calvinwalterheintzelman/Senior-Design-Project-Website/Team/progress/img/header.jpg

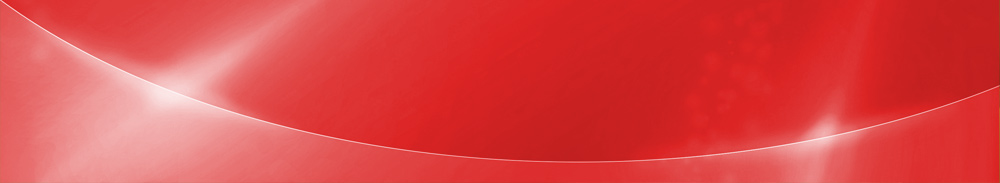
Team/progress/img/header.jpg
