calvinwalterheintzelman/Senior-Design-Project-Website/img/abiala/codec (2).JPG

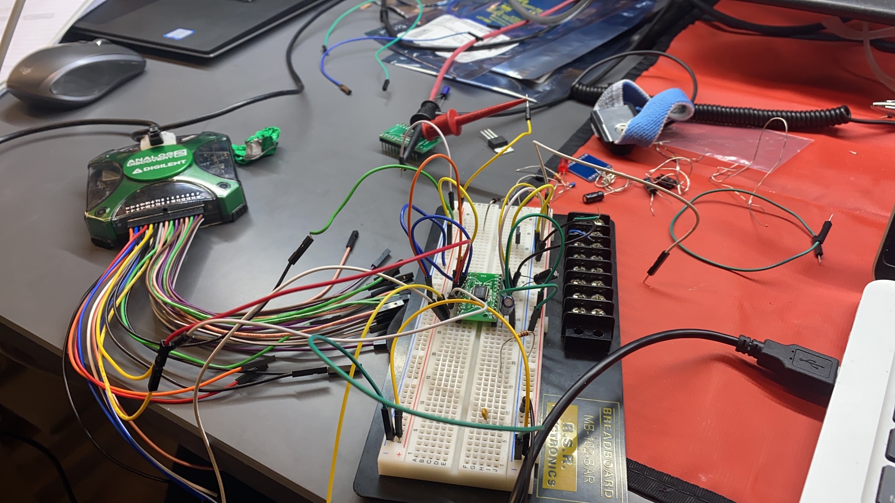
img/abiala/codec (2).JPG
