calvinwalterheintzelman/Senior-Design-Project-Website/Homeworks/Archive/Documents/team08-homework01 (PSSC's to be edited).docx

Final Project Proposal

Year: 2020

Semester: Spring

Team: 8

Project Name: AudioBeamer

Creation Date: November 3, 2019

Last Modified: January 5th, 2019

Team Members (#1 is Team Leader):

Member 1: Carson Tabachka Email: ctabachk@purdue.edu

Member 2: Calvin Walter Heintzelman Email: cheintze@purdue.edu

Member 3: Aditya Biala Email: abiala@purdue.edu

Member 4: Aditya Thagarthi Arun Email: athagart@purdue.edu

1.0 Description of Problem:

Playing an electric guitar with an amplifier can be such a hassle when there are electric cords everywhere. Needing to constantly untangle and untie cords when all you want to do is jam is such a bummer. People who play guitar should be able to pick up and play their instrument seamlessly and effortlessly. Wireless technology is everywhere nowadays, so why is it not mainstream for guitar players to have wireless audio transmission between their guitars and amplifiers? There are about 16 million guitar players just in the United States [1] and all of them could potentially run into this issue when using an amplifier.

In addition to the proposed guitar application, we plan to make our system universal. It should be compatible with any electronic music instrument that outputs sound using a 3.5mm or 6.3mm audio port. (DJ Controllers, Digital synthesizer etc.)

2.0 Roles & Responsibilities:

1. Team Leader – Carson Tabachka
  - Carson has great interpersonal communication skills. He coordinated his environmental engineering team to best delegate tasks and ensure timely completion. He has interest in software design especially with respect to networking and security.
2. Systems Engineer – Aditya Thagarthi Arun
  - Aditya T A has interest in software development. He will also understand the PCB design in full in order to serve the role as a systems engineer in this team. He has personal interest in audio and has a prior experience with working on audio related projects. He will be responsible with tying the hardware and software components of this project.
3. Hardware Engineer – Aditya Biala
  - Aditya B. has experience with Audio Hardware Development during projects with his internship with the audio team at Amazon. Additionally, he has completed numerous audio projects involving PCB design and embedded software both personally and as part of coursework. He has a lot of interest in audio hardware, and therefore he will be responsible for reliable, robust hardware design of this project.
4. Software Engineer – Calvin Walter Heintzelman
  - Calvin has a personal interest in software engineering and has taken specialized classes regarding the topic, including a class in software for embedded systems. He has done personal projects and has developed websites, apps, and neural networks. He will therefore be primarily responsible for the proper functionality and quality of software/code.

2.1 Homework Assignment Responsibilities:

Design Component Homework | | Professional Component Homework
3-Software Overview | A.T.A | 9-Legal Analysis | C.W.H.
5-Electrical Overview | A.B. | 10-Reliability and Safety Analysis | A.B.
7-Mechanical Overview | C.T. | 11-Ethical/Environmental Analysis | C.T.
8-Software Formalization | C.W.H. | 12-User Manual | A.T.A.

Carson Tabachka - C.T. Aditya Thagarthi Arun - A.T.A.

Aditya Biala - A.B. Calvin Walter Heintzelman - C.W.H.

3.0 Estimated Budget:

Item | Estimated Price
Electrical
Microcontrollers | $30
3.5 mm to 6.35 mm converter https://www.amazon.com/UGREEN-6-35mm-Female-Stereo-Adapter/dp/B01D82XXGO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 | $8
NRF24L01 Transceiver | $10
Batteries | $20
PCB | $70
Miscellaneous Electrical components (resistors, wires, LEDs, etc) | $10
Non-Electrical
3D printing material | $25
Shipping Costs | $50
Total | $223

4.0 Project Specific Success Criteria:

1. The ability to interface with an external Audio Codec using I2S that delivers digital data sampled at a 16-bit resolution from an electric guitar and outputs analog audio.
2. The ability to use Bluetooth data received from an Android cell phone to control audio equalization on the Receiver PCB using UART.
3. The ability to apply audio effects & equalization such as bass, middle, treble, distortion, and reverb on digitally sampled audio using Digital Signal Processing.
4. The ability to use a developed Android app to pass user-customizable audio equalization data to the receiver MCU using inbuilt cell phone Bluetooth.
5. The ability to power the system using an external battery while being able to measure remaining battery levels using a coulomb meter and displaying it using an LED based UI.

5.0 Sources Cited:

[1] “Guitar Players in The United States.” Answers.Google.com. http://answers.google.com/answers/threadview/id/720968.html (accessed Nov. 7, 2019).
[2] “900 MHz vs 433 MHz for Urban Environments.” Electronics.StackExchange.com. https://electronics.stackexchange.com/questions/115429/900-mhz-vs-433-mhz-for-urban-environments (accessed Nov. 7, 2019).
[3] “ARISTA 16-097 3.5mm (Mini) to 6.3mm (1/4") Headphone Adapter.” Amazon.com. https://www.amazon.com/ARISTA-16-097-3-5mm-Headphone-Adapter/dp/B00009UVPN (accessed Nov. 7, 2019).
[4] R. Davis. “Cordless Guitar Transmitter.” Patents.Google.com. https://patents.google.com/patent/US5025704?oq=wireless+audio+transmitter+and+receiver+guitar (accessed Nov. 7, 2019).
[5] “Xvive U2 Guitar Wireless System with Rechargeable 2.4GHz Digital Guitar Transmitter and Receiver for Electric Guitar, Bass, Violin.” Amazon.com. https://www.amazon.com/Xvive-Wireless-Rechargeable-Transmitter-Receiver/dp/B01N4DSQBR?ref_=fsclp_pl_dp_1&th=1 (accessed Nov. 7, 2019).
[6] “Donner New Version Rechargeable Wireless System DWS-3 Digital Guitar Bass Audio Transmitter and Receiver.” Amazon.com. https://www.amazon.com/Donner-Rechargeable-Wireless-Transmitter-Receiver/dp/B07DHLCRKD?ref_=fsclp_pl_dp_6 (accessed Nov. 7, 2019).
[7] “Getaria 2.4GHZ Wireless Guitar System Built-in Rechargeable Lithium Battery Digital Transmitter Receiver for Electric Guitar Bass (Black).” Amazon.com. https://www.amazon.com/Getaria-Wireless-Rechargeable-Transmitter-Receiver/dp/B07L5B64RG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 (accessed Nov. 7, 2019).
[8] 胡宇鹏. “Wireless Transmitter Suitable for Electric Guitar.” Patents.Google.com. https://patents.google.com/patent/CN205140505U/en?oq=guitar+transmitter (accessed Nov. 7, 2019).
[9] M. Kleinsorge and C. Budnik. “High-Frequency Transmitter, Wireless Microphone and Guitar Transmitter or Pocket Transmitter.” Patents.Google.com. https://patents.google.com/patent/US20150303886?oq=guitar+transmitter (accessed Nov. 7, 2019).
[10] “FM-Based Wireless Electric Guitar!” Instructables.com. https://www.instructables.com/id/FM-based-Wireless-Electric-Guitar/ (accessed Nov. 7, 2019).
[11] “Beetle Mk III: Connect your Guitar to the Airwaves.” TalkingElectronics.com. http://www.talkingelectronics.com/projects/BeetleMklll/BeetleMkIII.html (accessed Nov. 7, 2019).
[12] M. Caldeira. “DIY Wireless Guitar System Using NRF24L01.” YouTube.com. https://www.youtube.com/watch?v=66lN1GD_TN4 (accessed Nov. 7, 2019).

Appendix 1: Concept Sketch

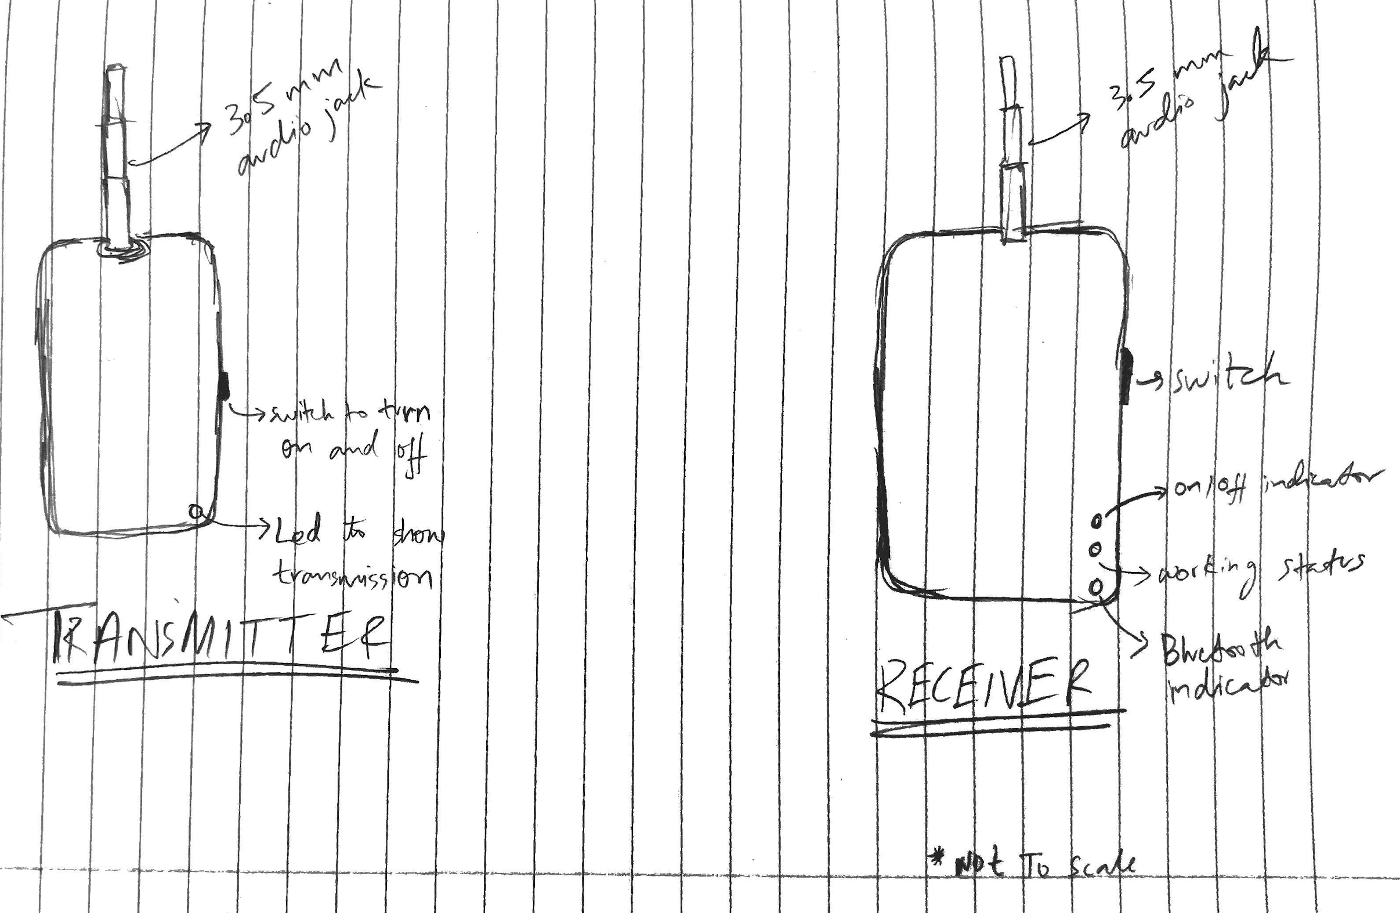
[picture p50: figure]
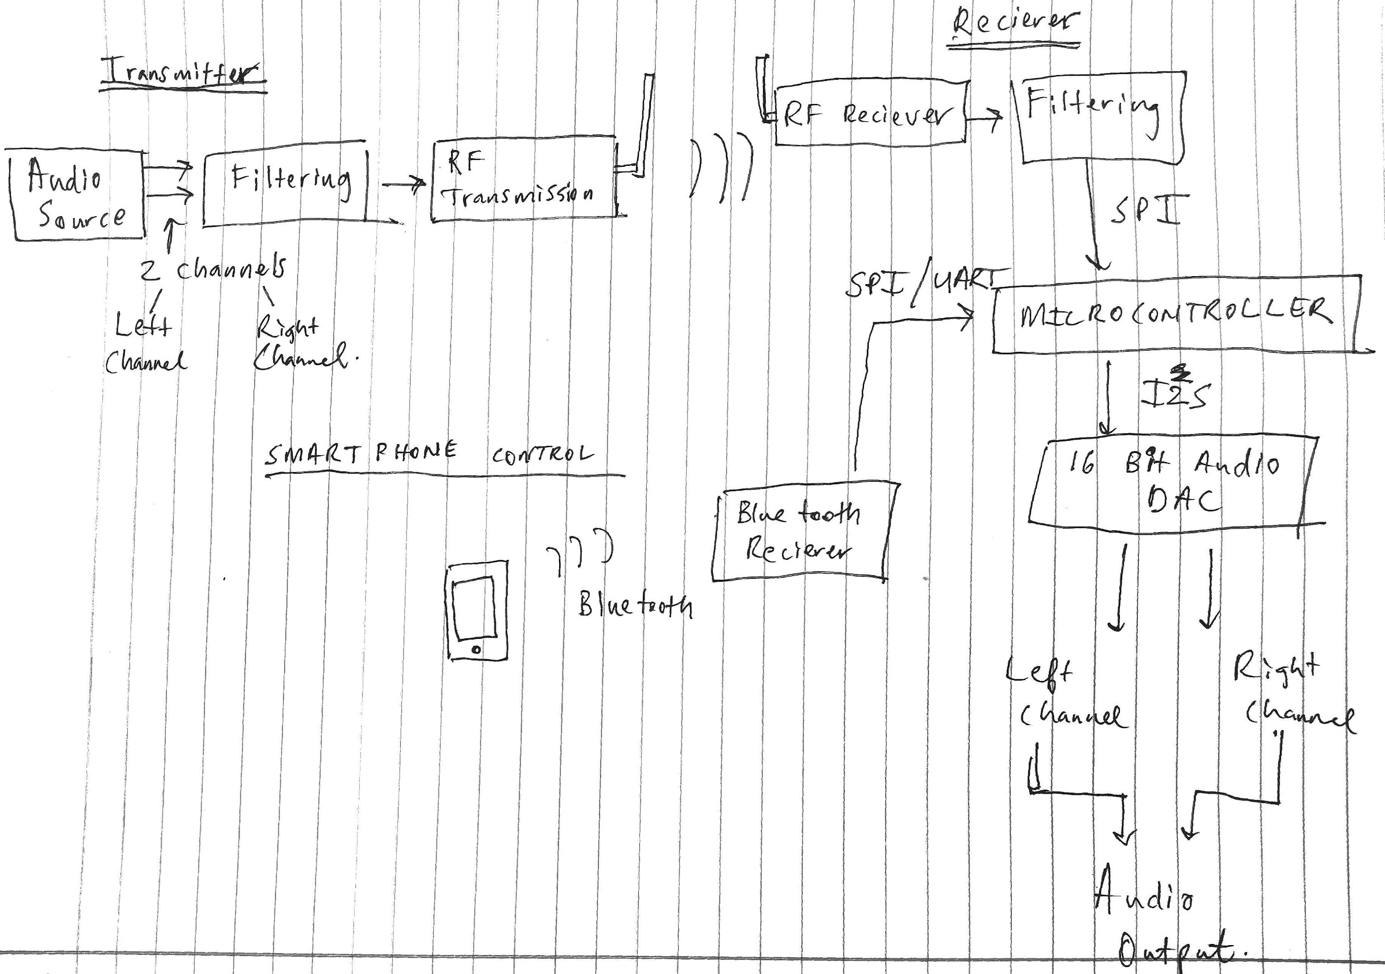
[picture p51: figure]
