calvinwalterheintzelman/Senior-Design-Project-Website/Homeworks/Archive/Documents/Midterm Design Reveiw/GANT chart.xlsx

Task | Week 8 | Week 9 | Week 10 | Week 11 | Week 12 | Week 13 | Week 14 | Week 15 | Week 16
Audio Codec Interfacing
Order PCB
DSP Development
Android App UI Improvements
Soldering
Software Debugging
Hardware Debugging
Product testing
Assembly
Quality of Life Improvements
Finalize PCB Designs
PMIC Interfacing
