calvinwalterheintzelman/Senior-Design-Project-Website/img/abiala.jpg

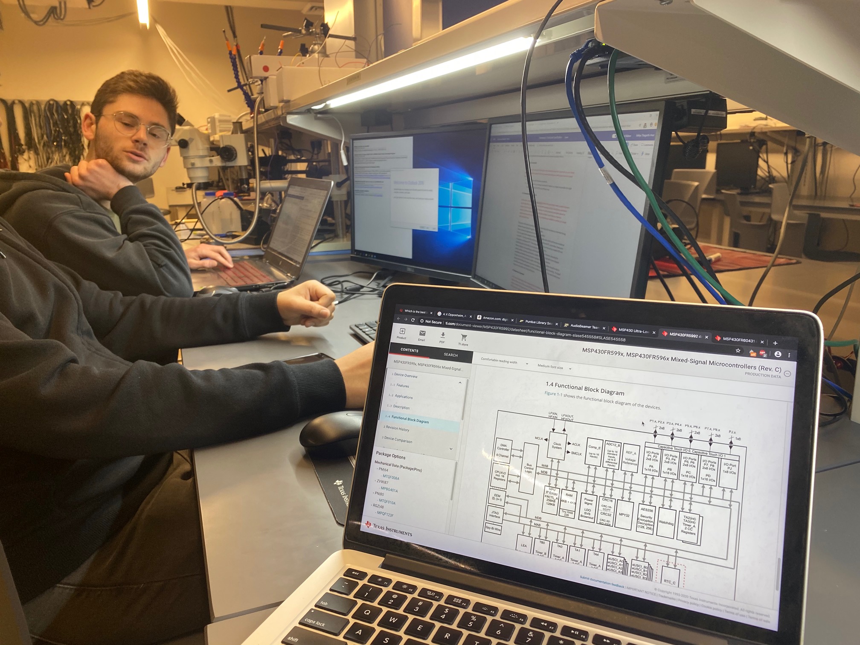
img/abiala.jpg
