calvinwalterheintzelman/Senior-Design-Project-Website/img/abiala/1.jpg

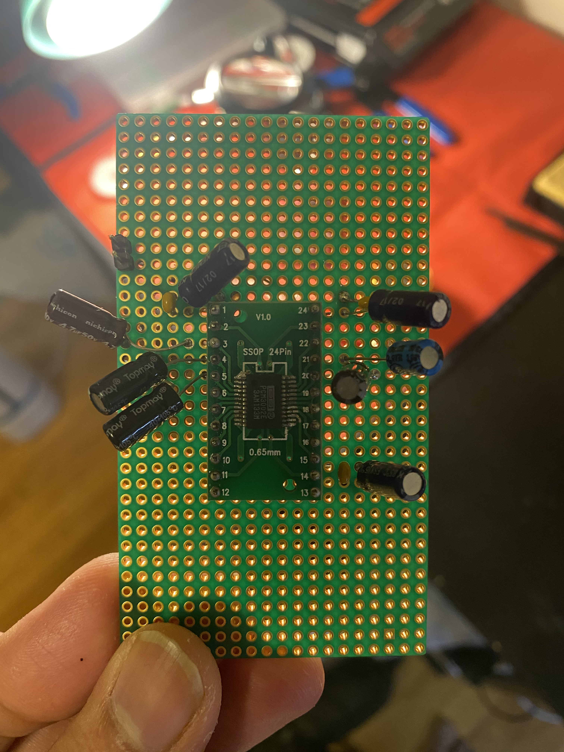
img/abiala/1.jpg
