calvinwalterheintzelman/Senior-Design-Project-Website/img/abiala/2.jpg

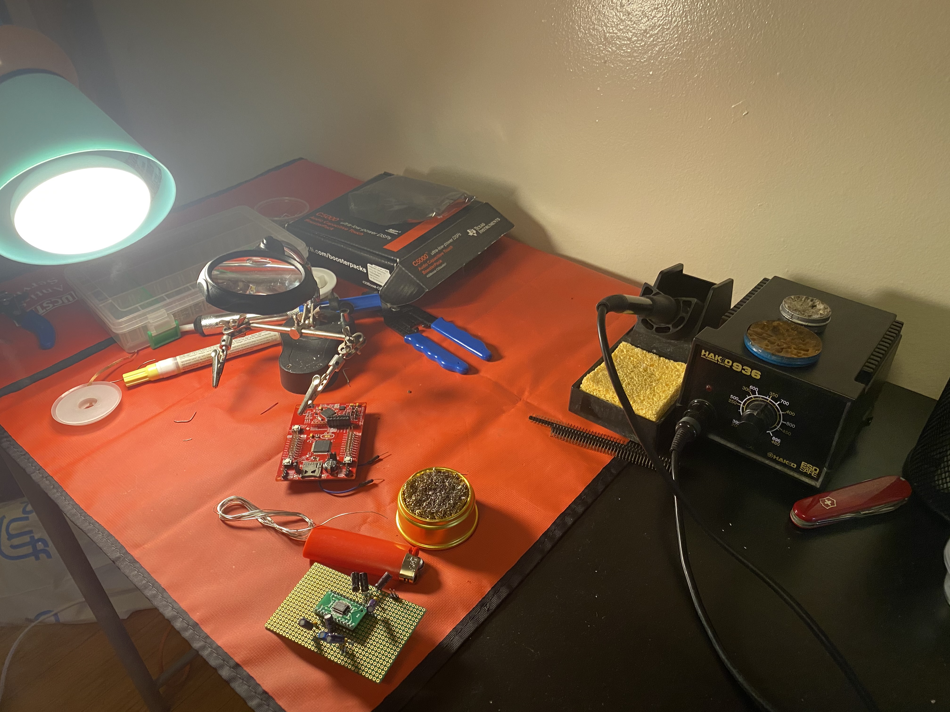
img/abiala/2.jpg
