calvinwalterheintzelman/Senior-Design-Project-Website/img/abiala/circuit.jpg

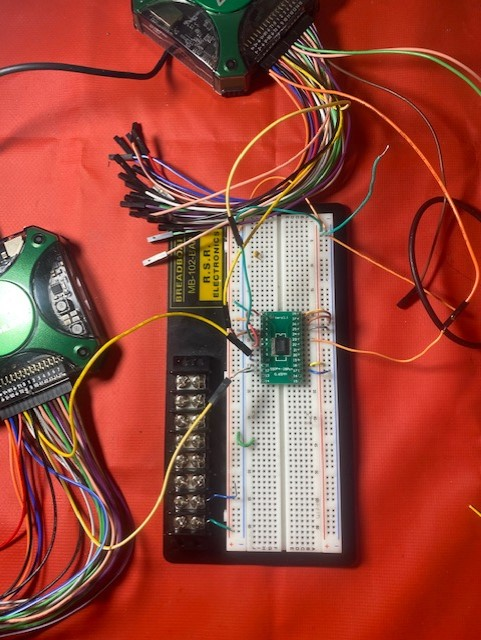
img/abiala/circuit.jpg
