calvinwalterheintzelman/Senior-Design-Project-Website/img/abiala/crystal.jpg

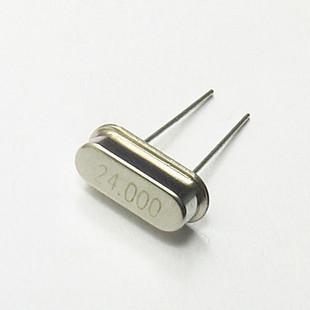
img/abiala/crystal.jpg
