calvinwalterheintzelman/Senior-Design-Project-Website/img/abiala/dsp.png

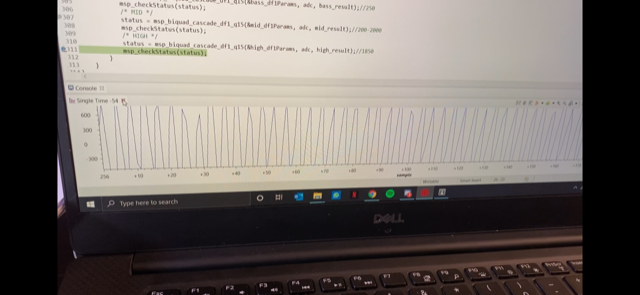
img/abiala/dsp.png
