calvinwalterheintzelman/Senior-Design-Project-Website/img/abiala/footprint.png

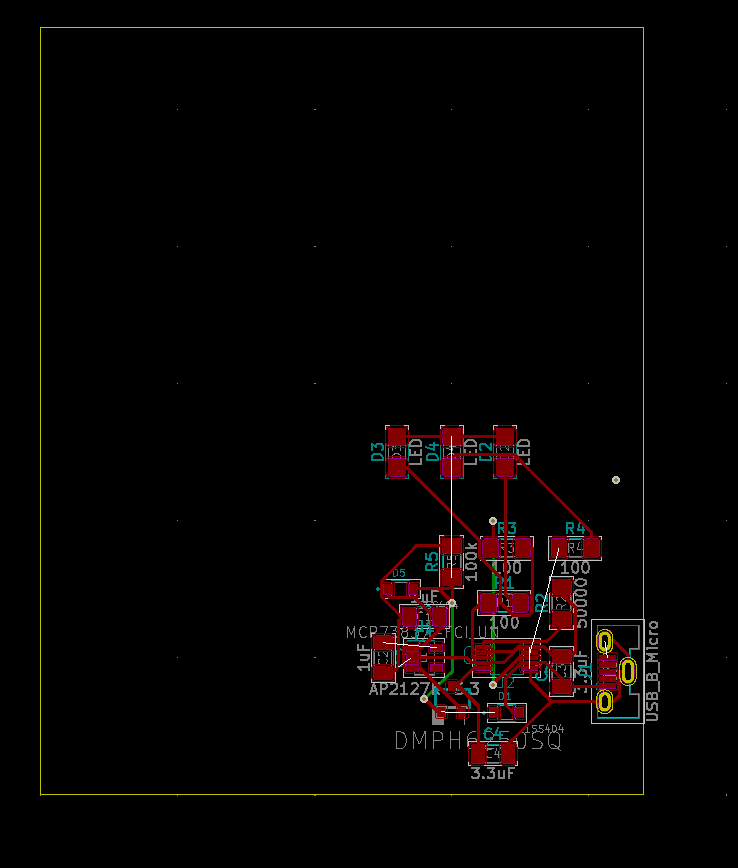
img/abiala/footprint.png
