calvinwalterheintzelman/Senior-Design-Project-Website/img/abiala/msp.png

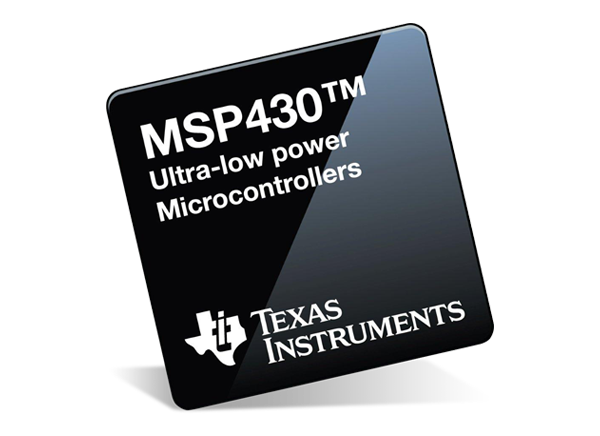
img/abiala/msp.png
