calvinwalterheintzelman/Senior-Design-Project-Website/img/abiala/new_codec.jpg

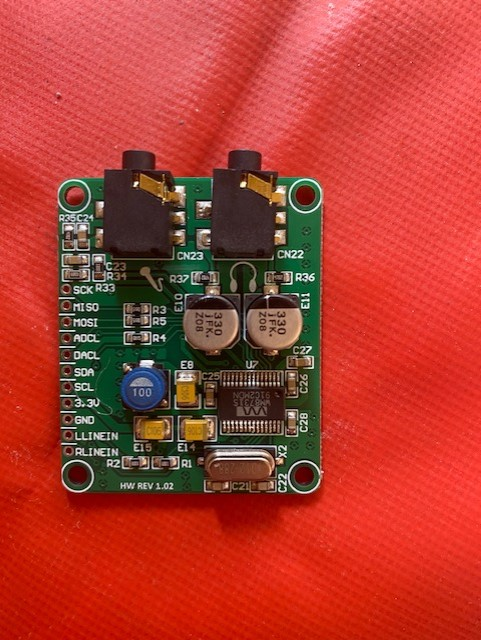
img/abiala/new_codec.jpg
