calvinwalterheintzelman/Senior-Design-Project-Website/img/abiala/pcb1.png

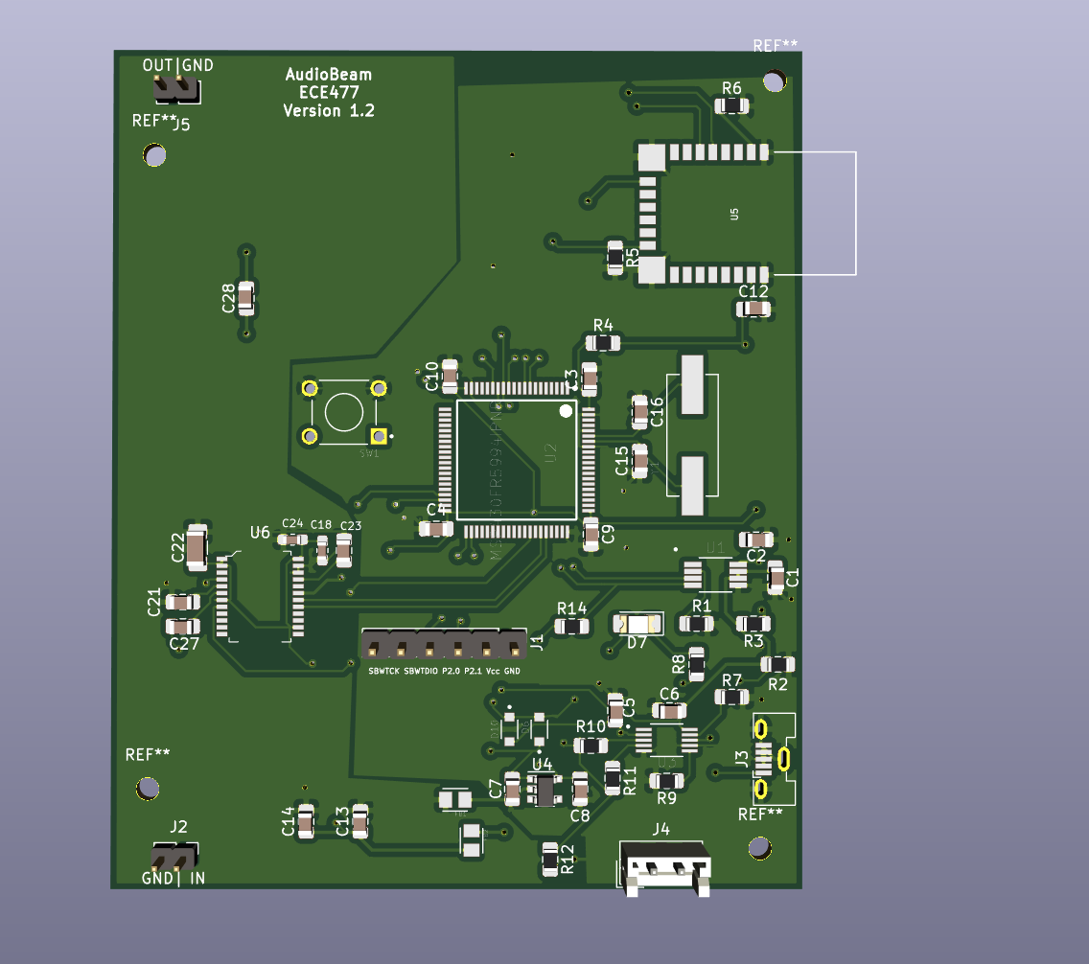
img/abiala/pcb1.png
