calvinwalterheintzelman/Senior-Design-Project-Website/img/abiala/PCB.png

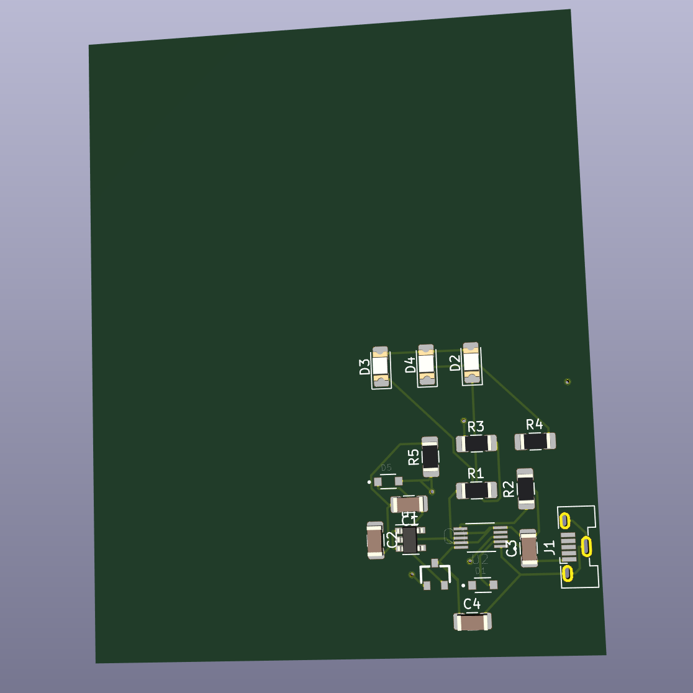
img/abiala/PCB.png
