calvinwalterheintzelman/Senior-Design-Project-Website/img/app1 (2).JPG

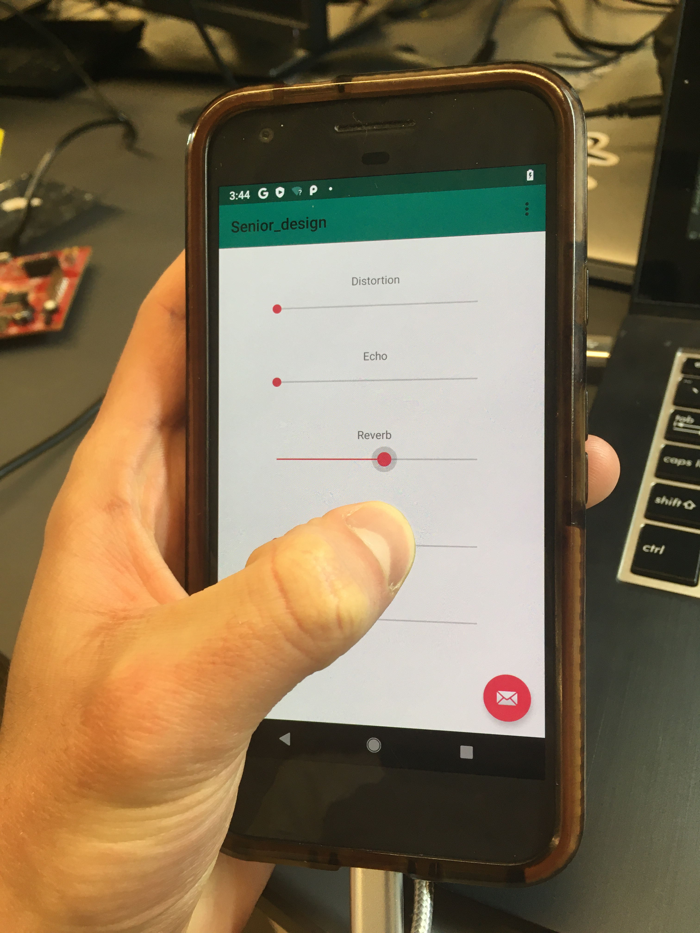
img/app1 (2).JPG
