calvinwalterheintzelman/Senior-Design-Project-Website/img/athagart/athagart2.jpg

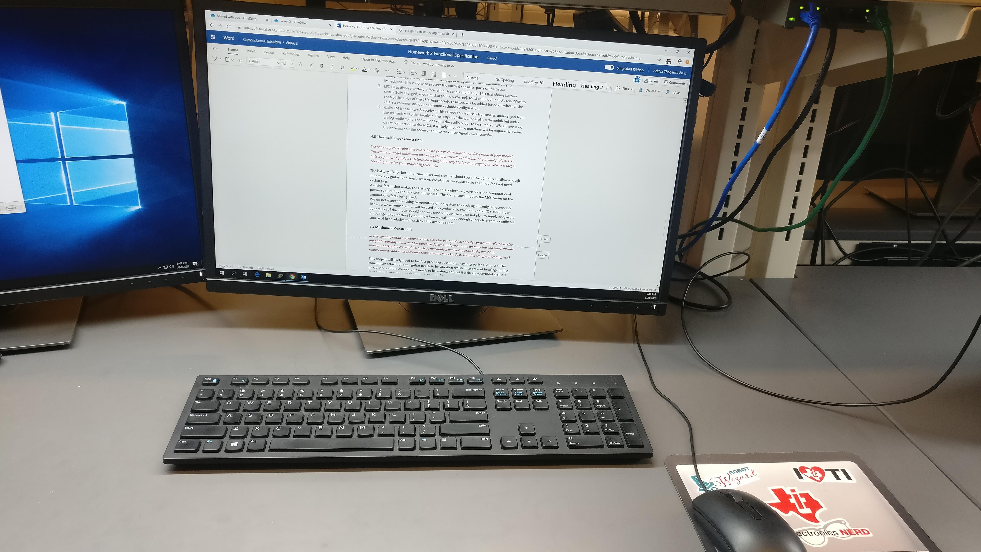
img/athagart/athagart2.jpg
