calvinwalterheintzelman/Senior-Design-Project-Website/img/athagart/athagart3a.png

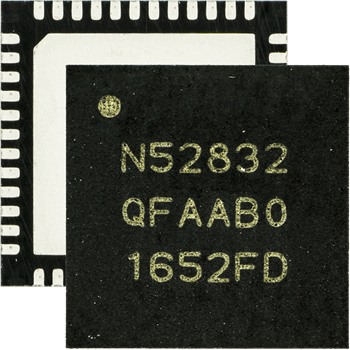
img/athagart/athagart3a.png
