calvinwalterheintzelman/Senior-Design-Project-Website/img/athagart/athagart3b.png

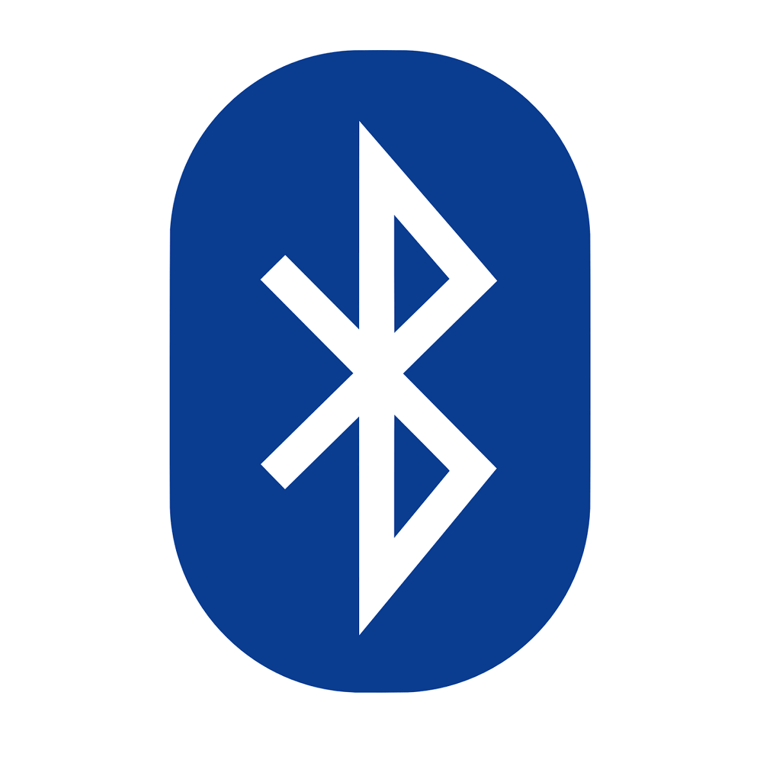
img/athagart/athagart3b.png
