calvinwalterheintzelman/Senior-Design-Project-Website/img/athagart/athagart3c.png

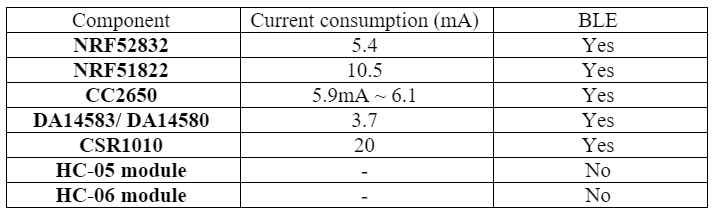
img/athagart/athagart3c.png
