calvinwalterheintzelman/Senior-Design-Project-Website/img/athagart/Capture.JPG

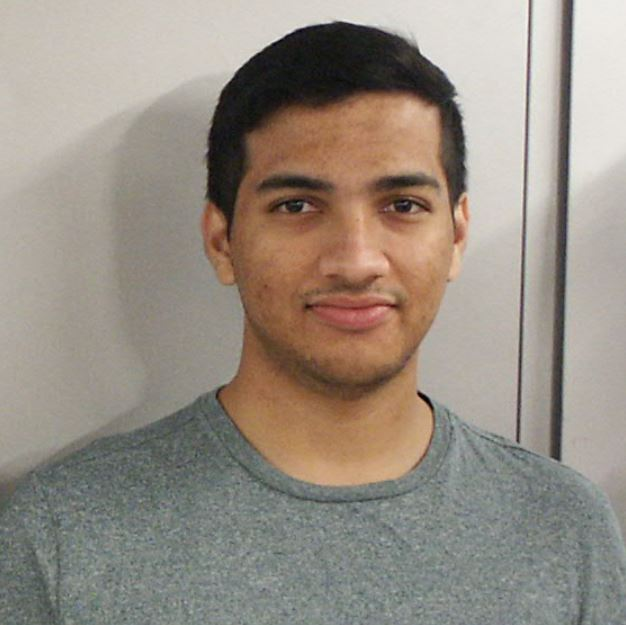
img/athagart/Capture.JPG
