calvinwalterheintzelman/Senior-Design-Project-Website/img/athagart/image.png

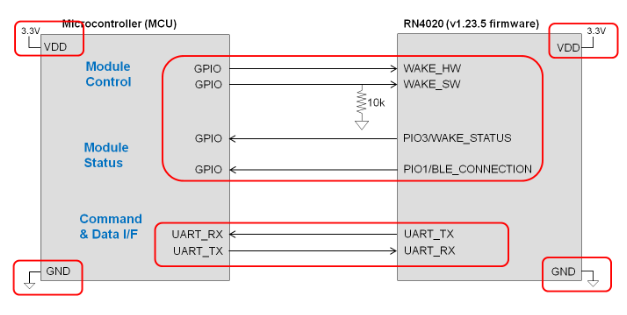
img/athagart/image.png
