calvinwalterheintzelman/Senior-Design-Project-Website/img/athagart/rn4020.jpg

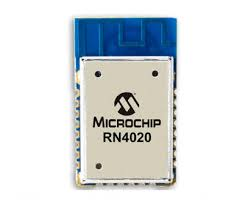
img/athagart/rn4020.jpg
