calvinwalterheintzelman/Senior-Design-Project-Website/img/athagart/week6a.png

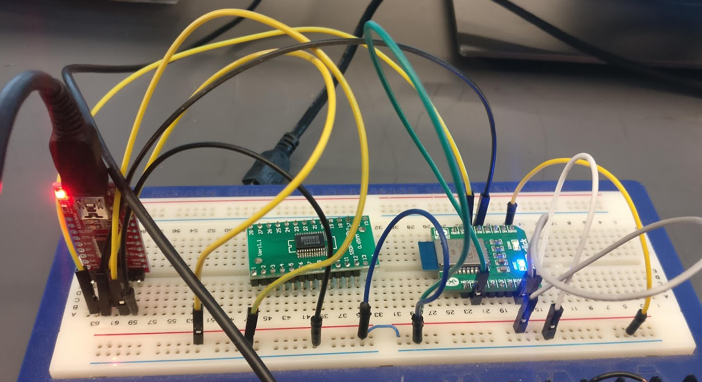
img/athagart/week6a.png
