calvinwalterheintzelman/Senior-Design-Project-Website/img/athagart/week6b.png

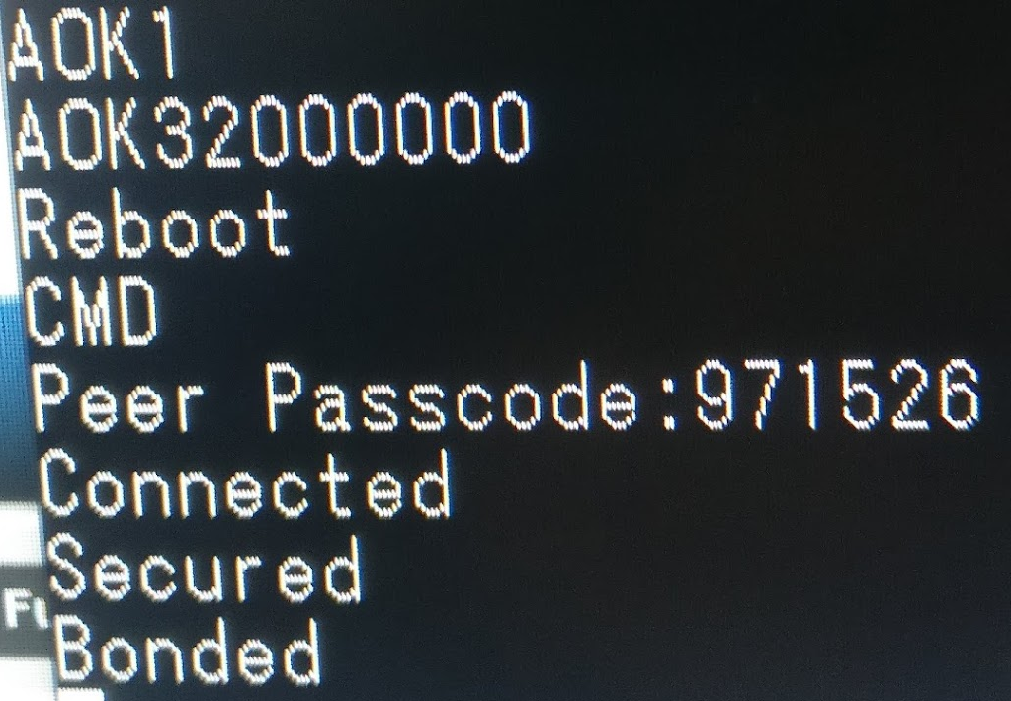
img/athagart/week6b.png
