calvinwalterheintzelman/Senior-Design-Project-Website/img/athagart/week7a.png

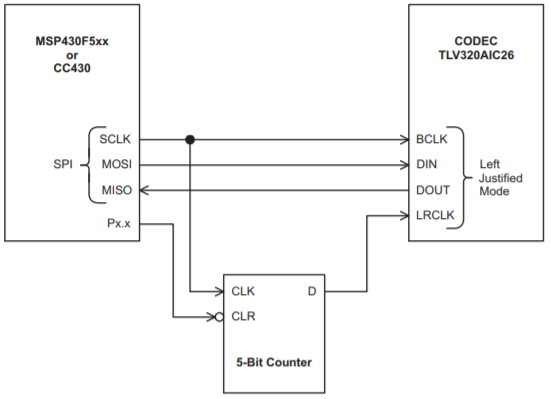
img/athagart/week7a.png
