calvinwalterheintzelman/Senior-Design-Project-Website/img/athagart/week7b.png

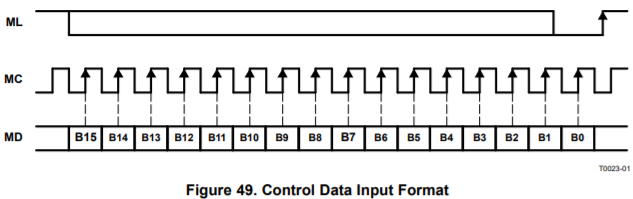
img/athagart/week7b.png
