calvinwalterheintzelman/Senior-Design-Project-Website/img/athagart/week8.png

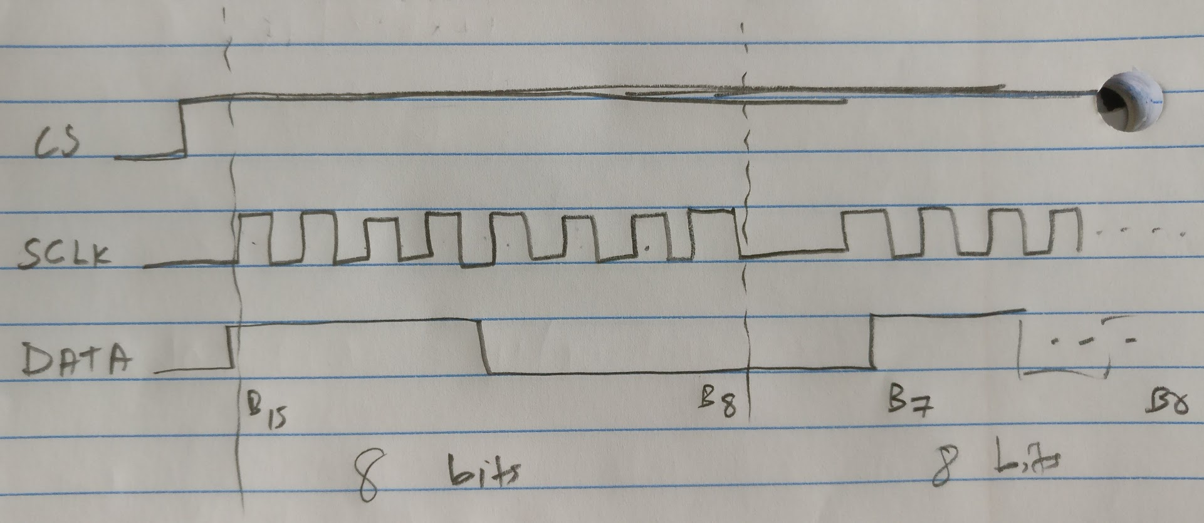
img/athagart/week8.png
