calvinwalterheintzelman/Senior-Design-Project-Website/img/athagart/week12.png

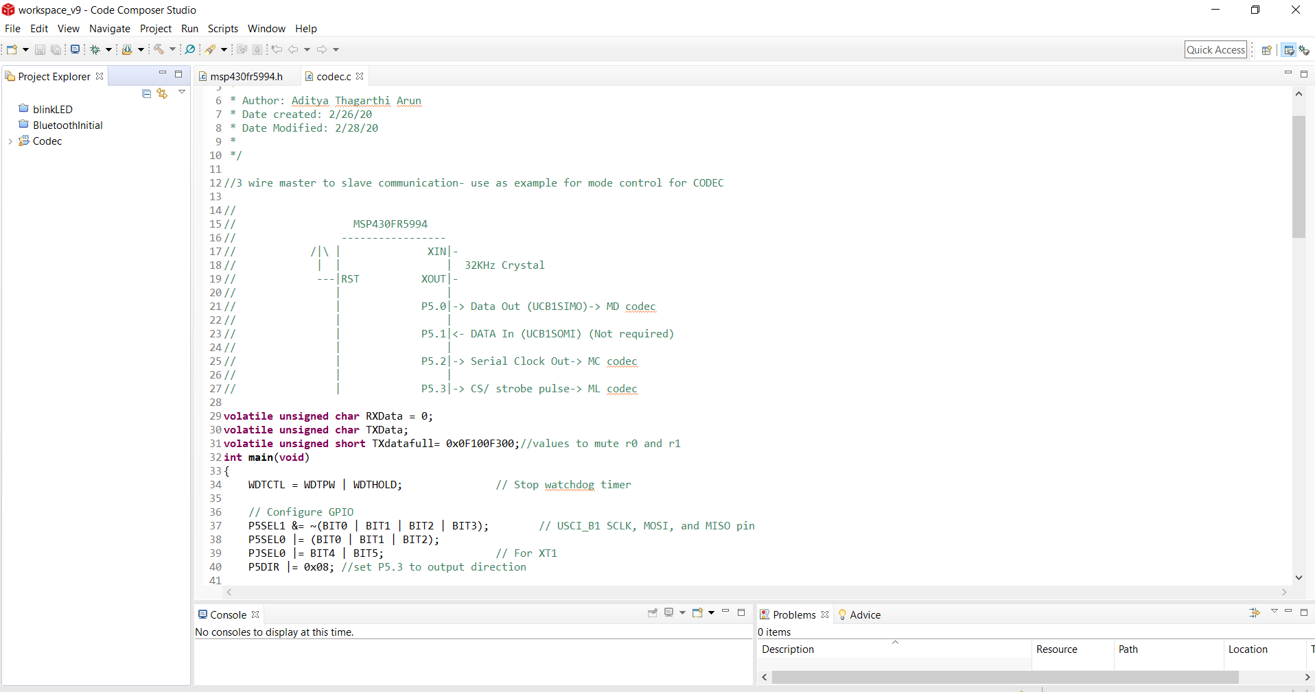
img/athagart/week12.png
