calvinwalterheintzelman/Senior-Design-Project-Website/img/athagart/week13.png

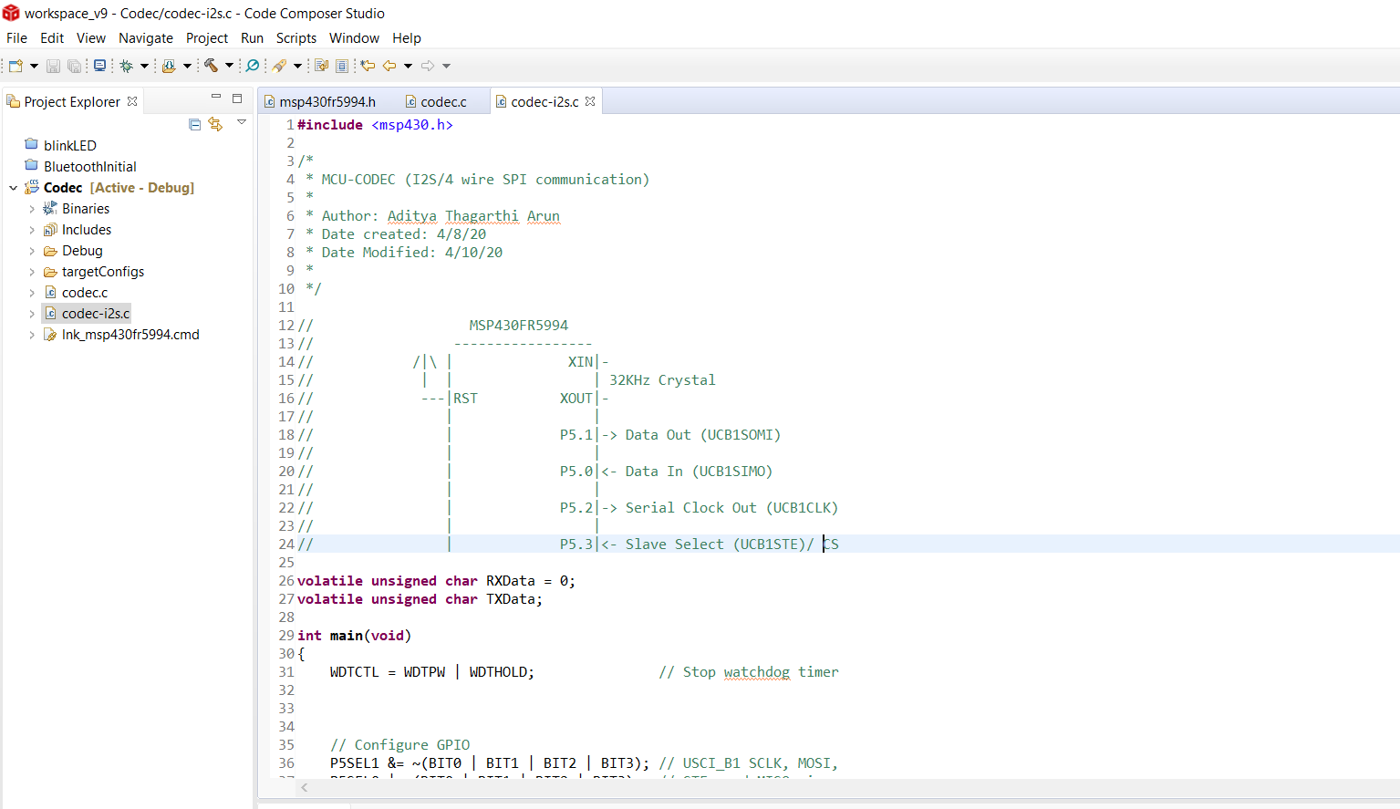
img/athagart/week13.png
