calvinwalterheintzelman/Senior-Design-Project-Website/img/athagart/week14a.jpg

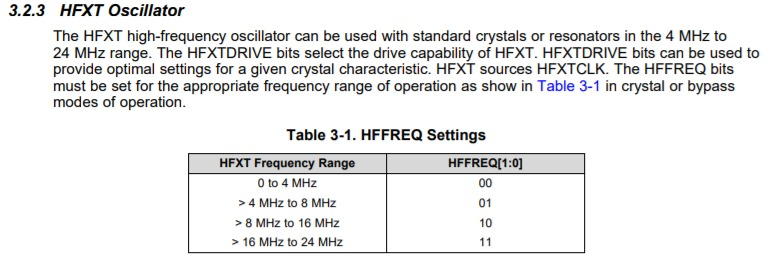
img/athagart/week14a.jpg
