calvinwalterheintzelman/Senior-Design-Project-Website/img/athagart/week15.jpg

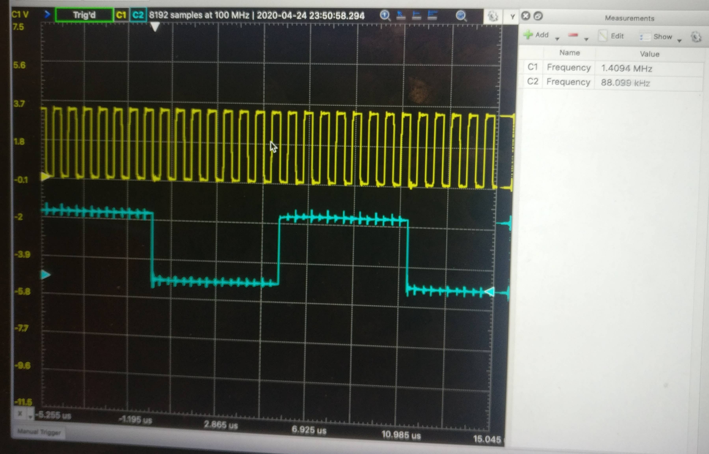
img/athagart/week15.jpg
