calvinwalterheintzelman/Senior-Design-Project-Website/img/circuit2.png

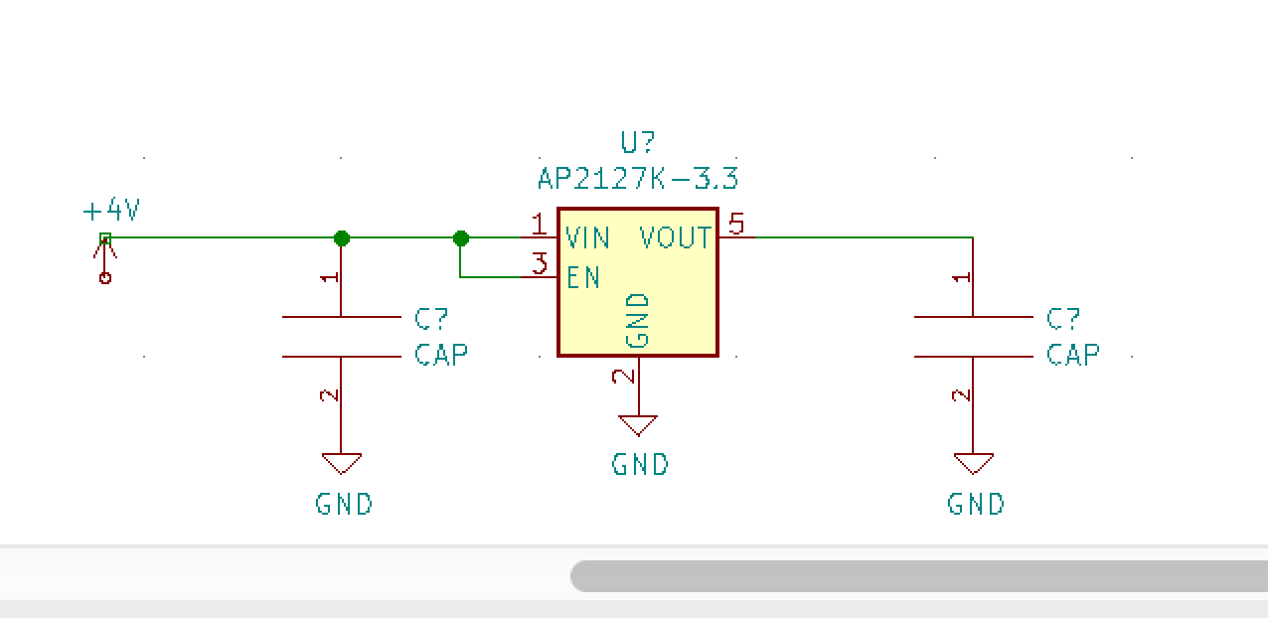
img/circuit2.png
