calvinwalterheintzelman/Senior-Design-Project-Website/img/circuit.png

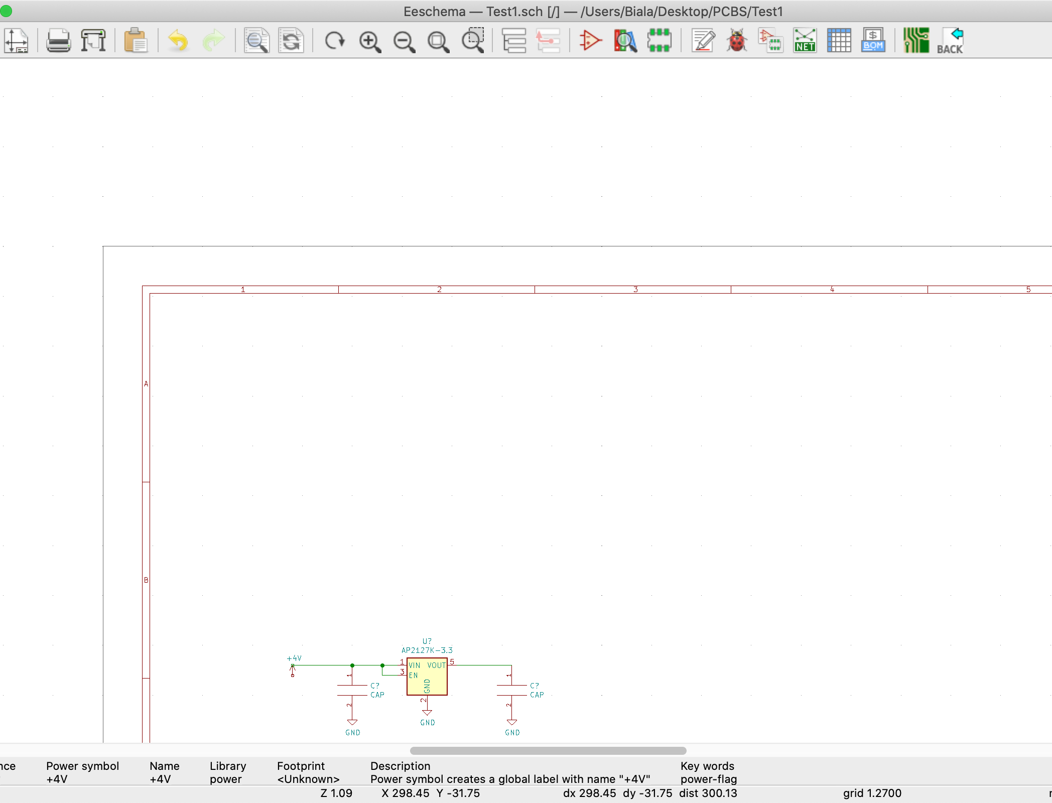
img/circuit.png
