calvinwalterheintzelman/Senior-Design-Project-Website/img/code1.png

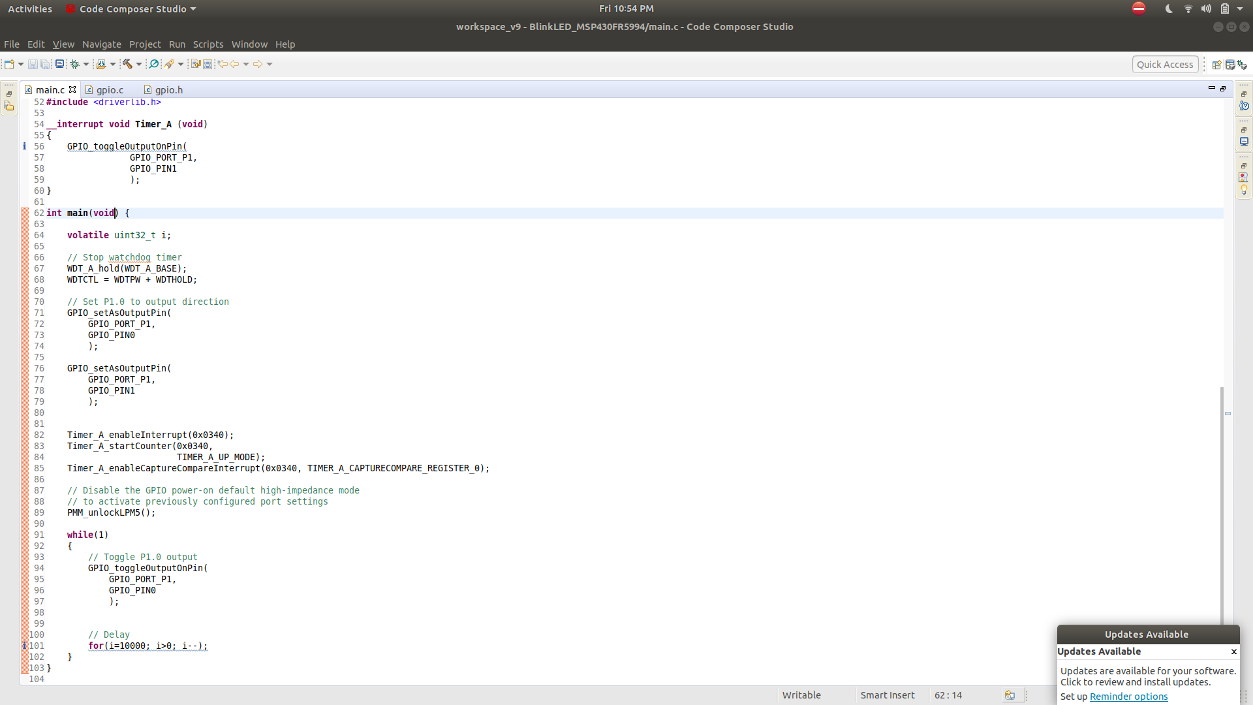
img/code1.png
