calvinwalterheintzelman/Senior-Design-Project-Website/img/code2.png

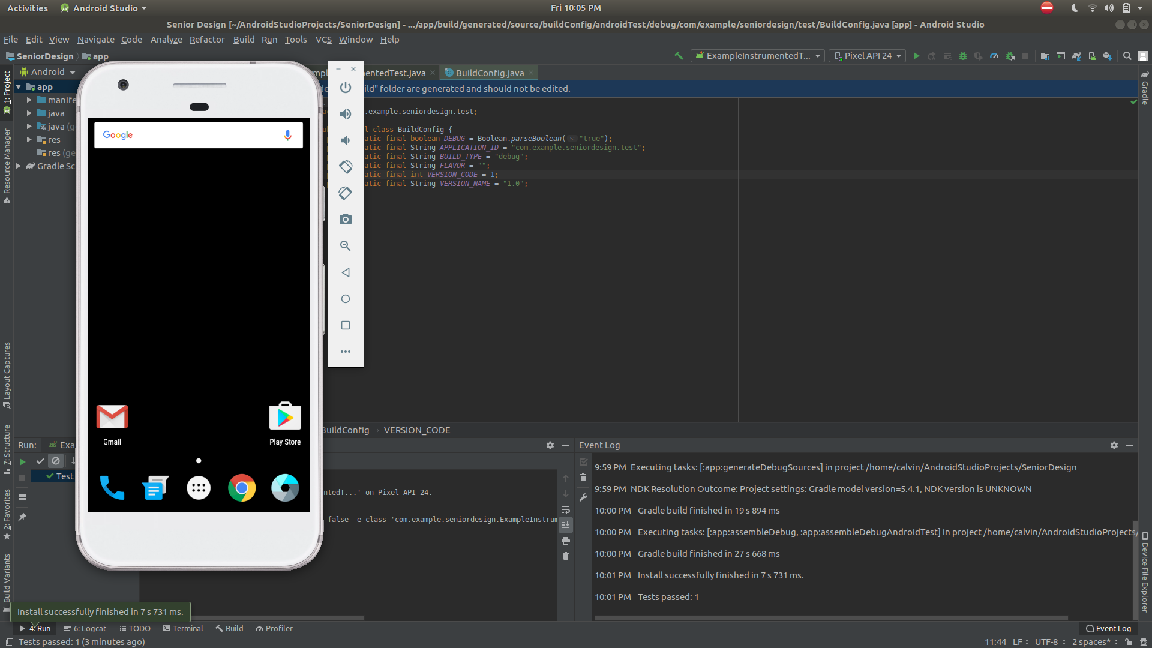
img/code2.png
