calvinwalterheintzelman/Senior-Design-Project-Website/img/code.png

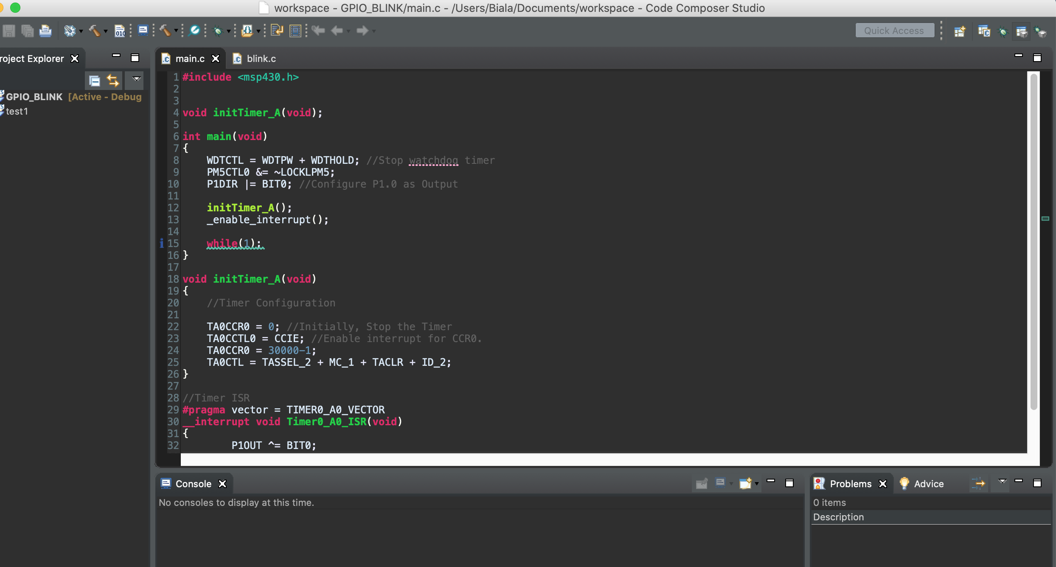
img/code.png
