calvinwalterheintzelman/Senior-Design-Project-Website/img/ctabachk_week2.jpg

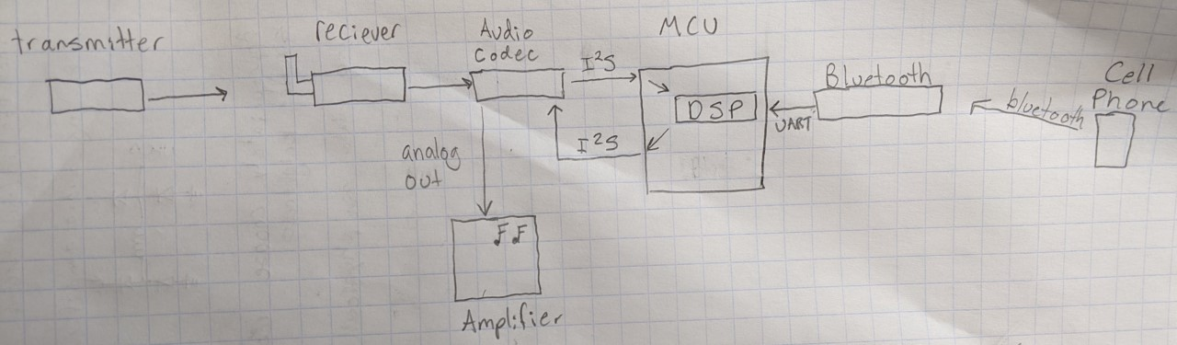
img/ctabachk_week2.jpg
