calvinwalterheintzelman/Senior-Design-Project-Website/img/ctabachk_week3.jpg

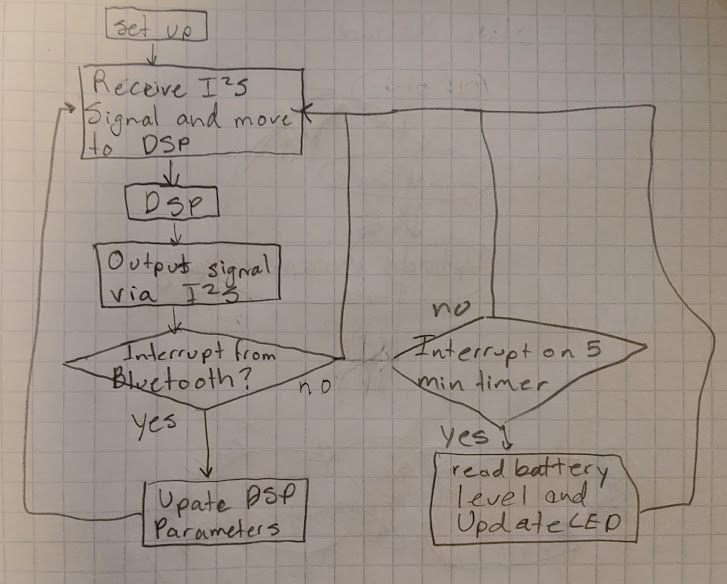
img/ctabachk_week3.jpg
