calvinwalterheintzelman/Senior-Design-Project-Website/img/ctabachk_week4.jpg

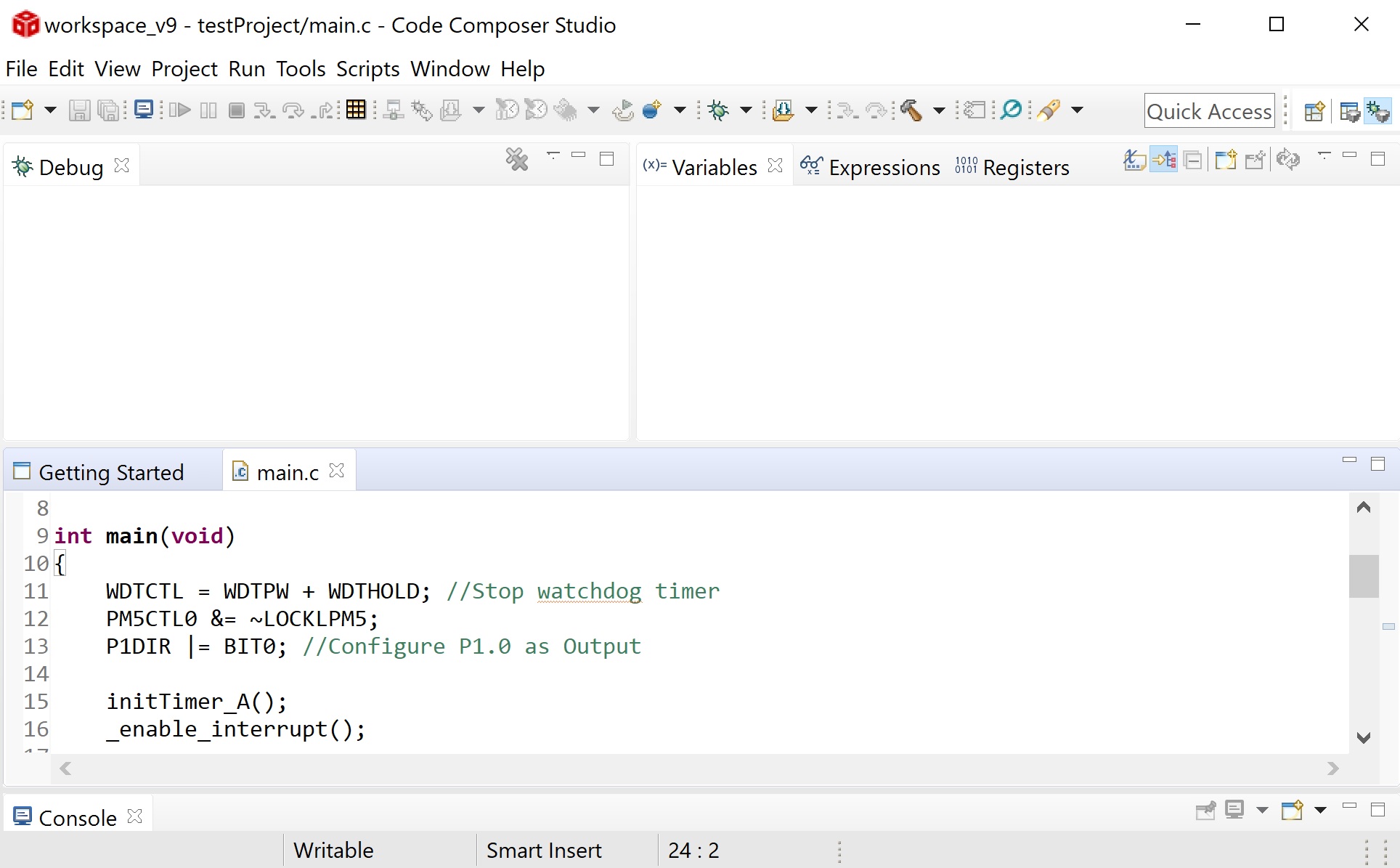
img/ctabachk_week4.jpg
