calvinwalterheintzelman/Senior-Design-Project-Website/img/ctabachk_week5.jpg

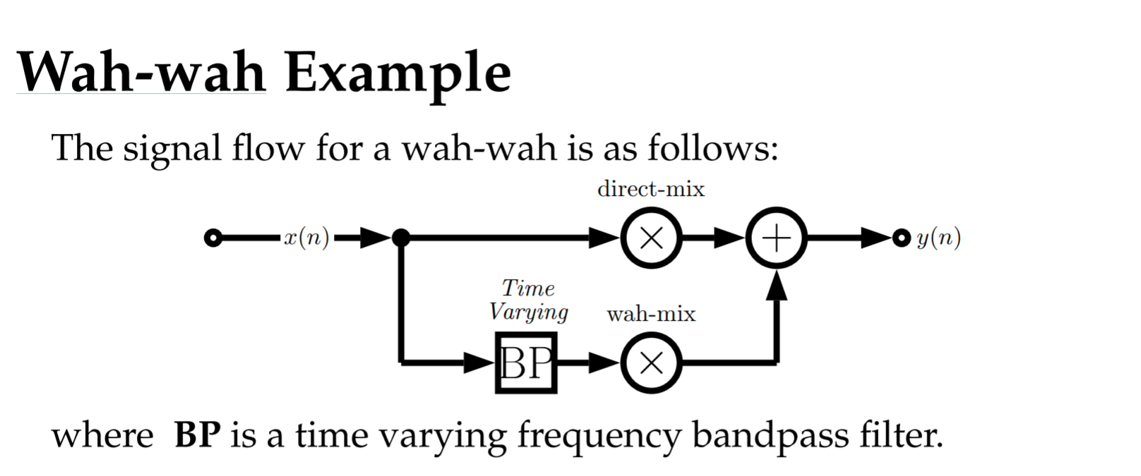
img/ctabachk_week5.jpg
