calvinwalterheintzelman/Senior-Design-Project-Website/img/ctabachk_week6_0.jpg

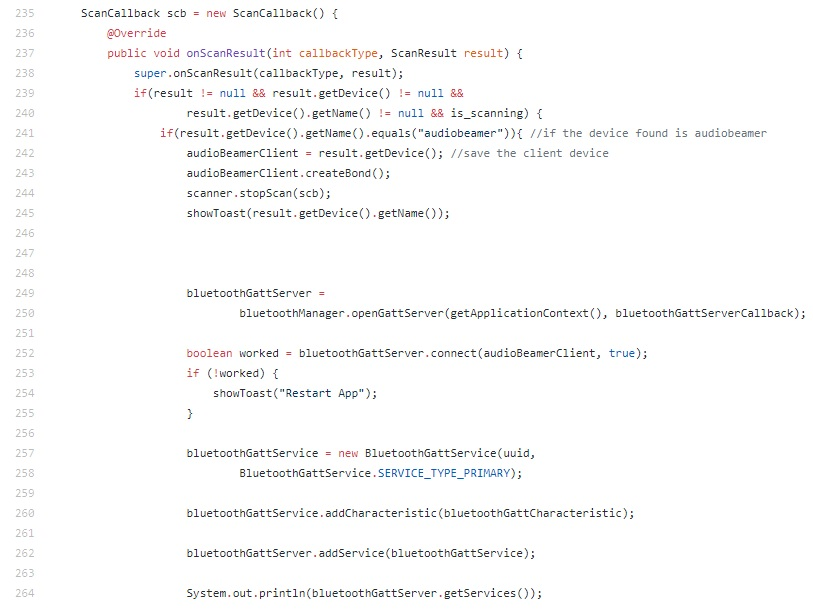
img/ctabachk_week6_0.jpg
