calvinwalterheintzelman/Senior-Design-Project-Website/img/ctabachk_week7.jpg

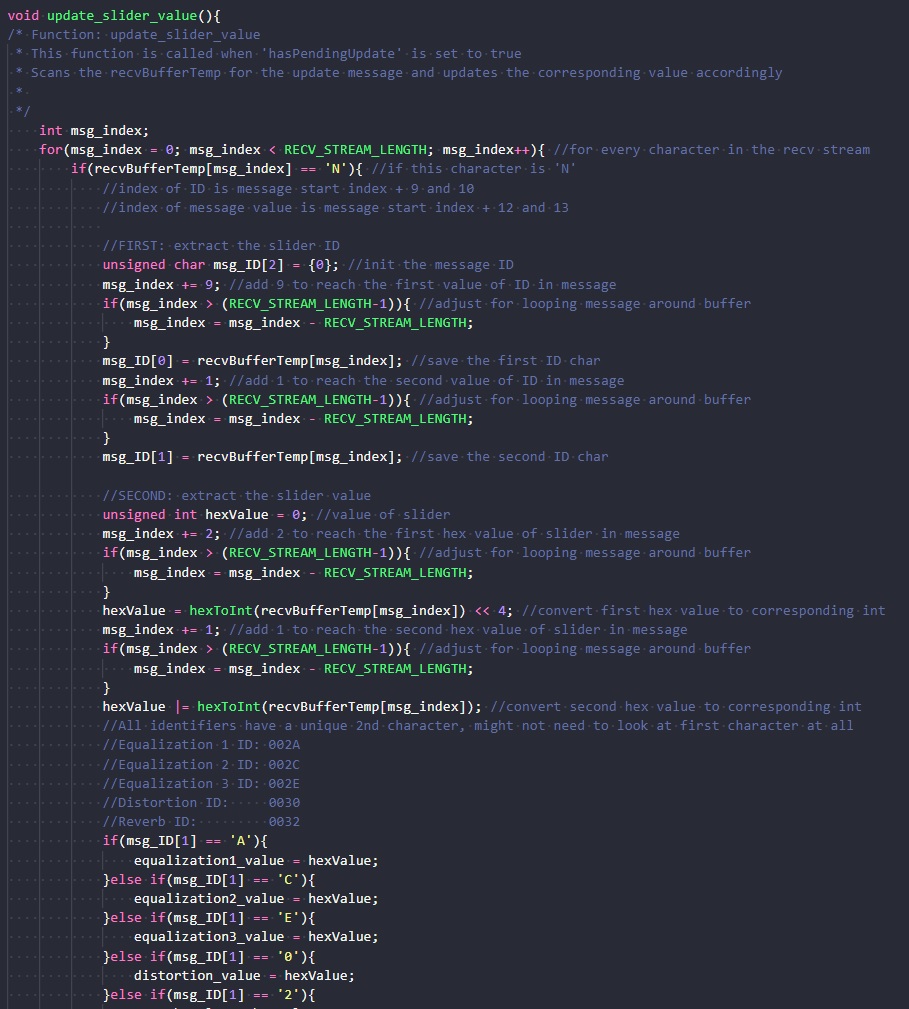
img/ctabachk_week7.jpg
