calvinwalterheintzelman/Senior-Design-Project-Website/img/ctabachk_week8.jpg

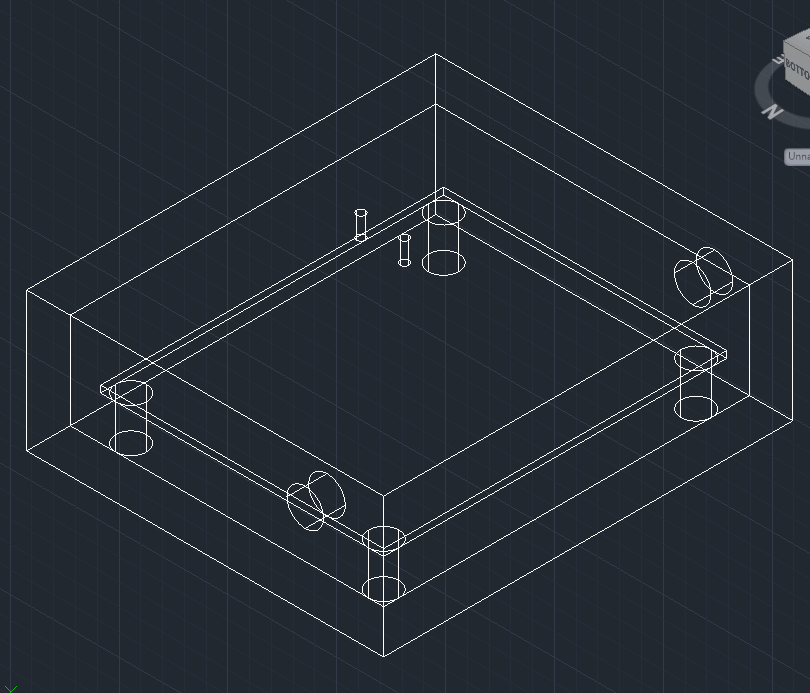
img/ctabachk_week8.jpg
