calvinwalterheintzelman/Senior-Design-Project-Website/img/ctabachk_week11.jpg

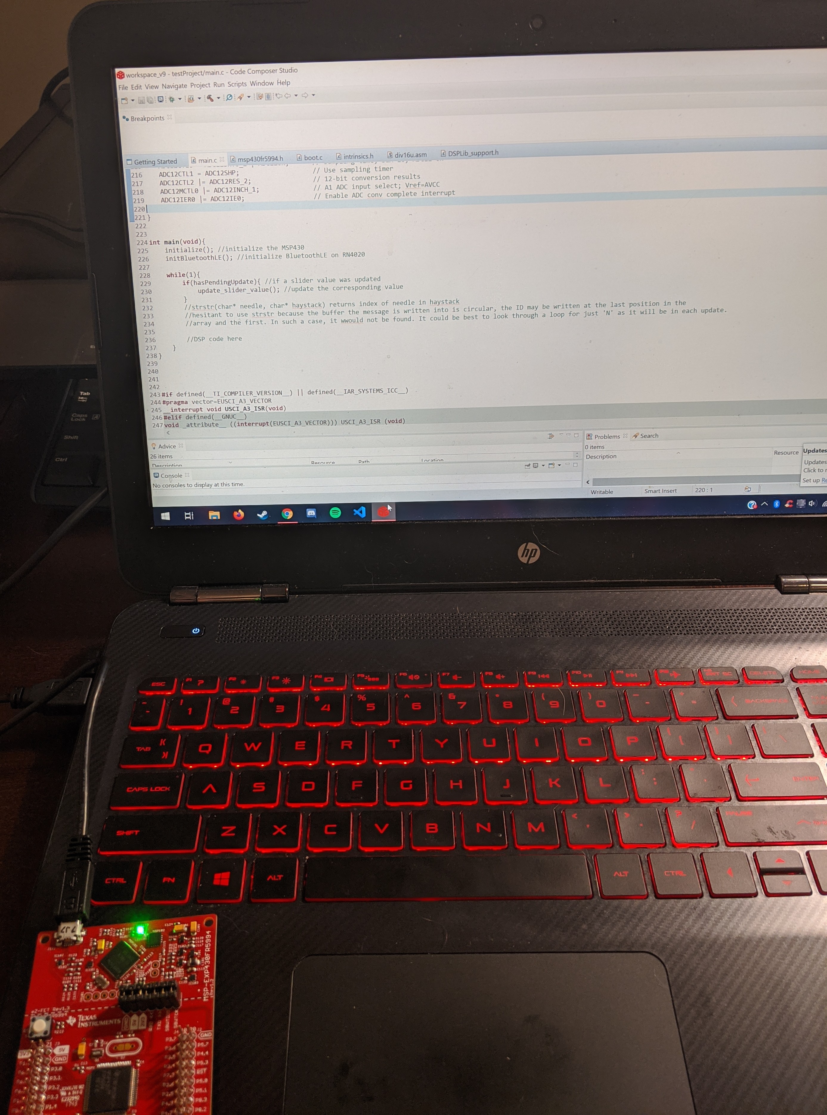
img/ctabachk_week11.jpg
