calvinwalterheintzelman/Senior-Design-Project-Website/img/ctabachk_week13.jpg

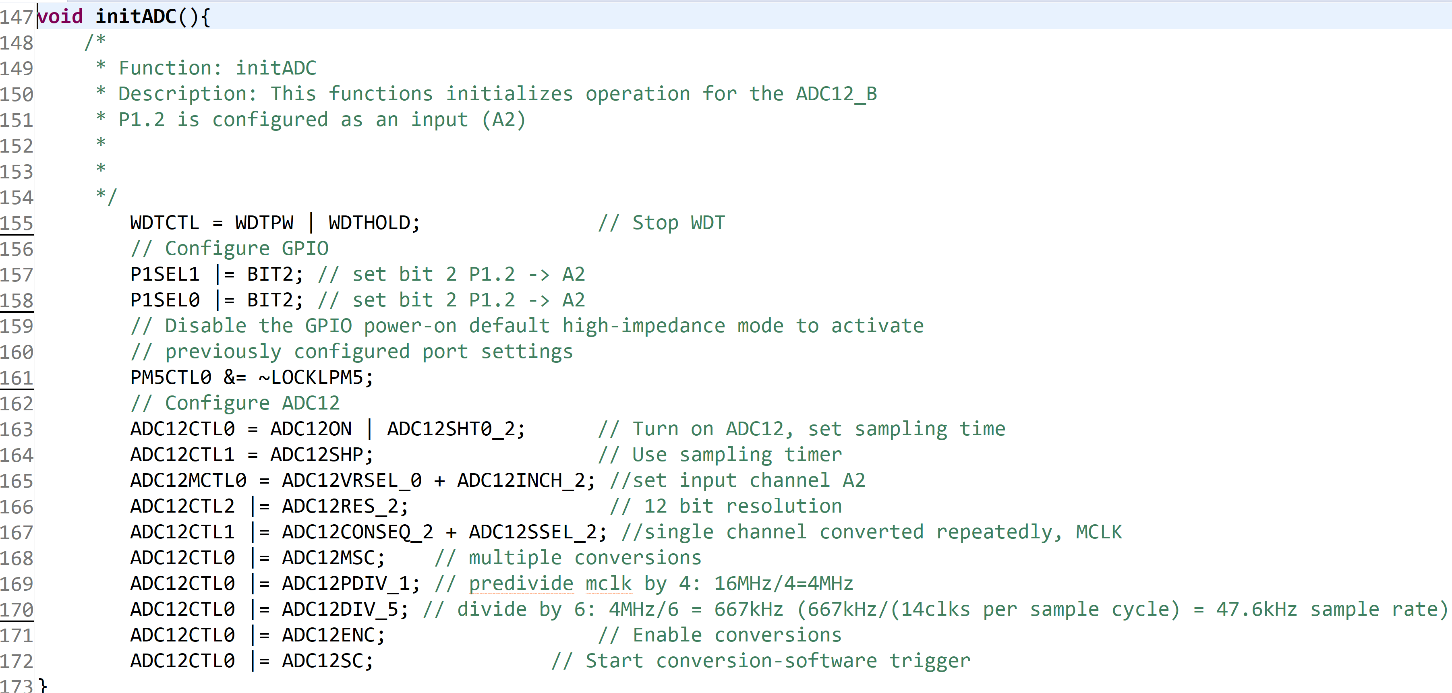
img/ctabachk_week13.jpg
