calvinwalterheintzelman/Senior-Design-Project-Website/img/ctabachk_week14.jpg

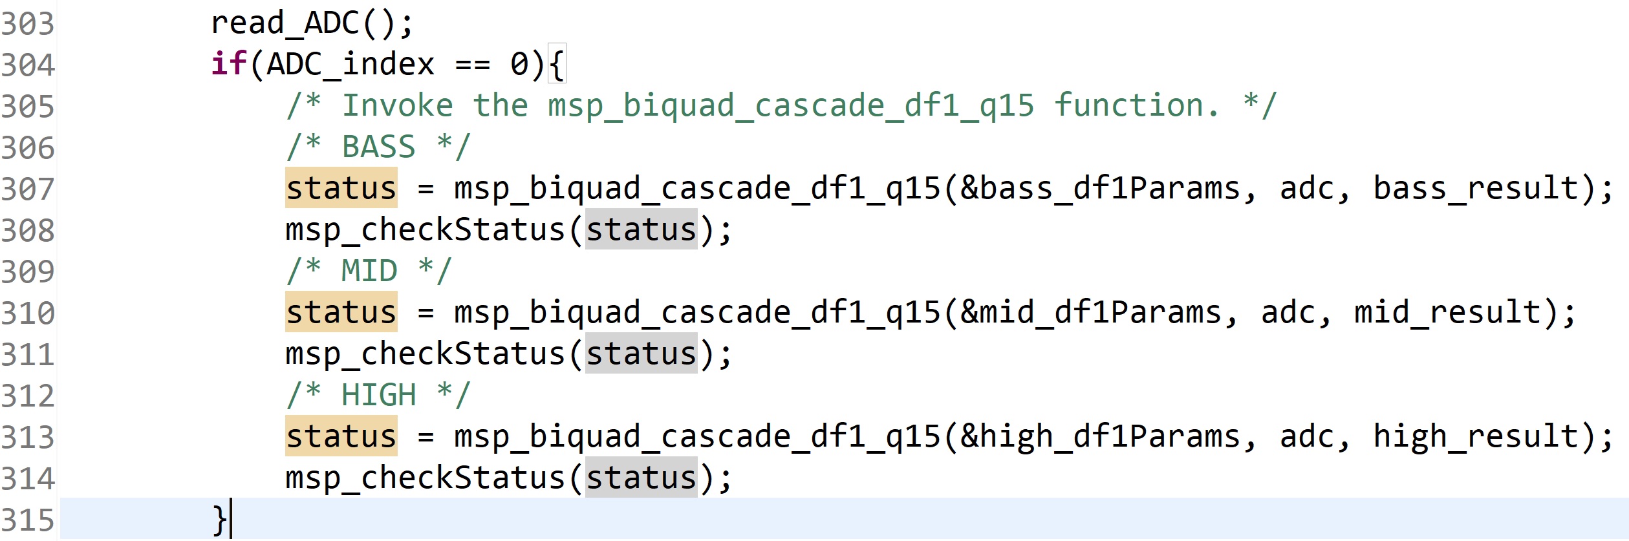
img/ctabachk_week14.jpg
