calvinwalterheintzelman/Senior-Design-Project-Website/img/ctabachk_week15.jpg

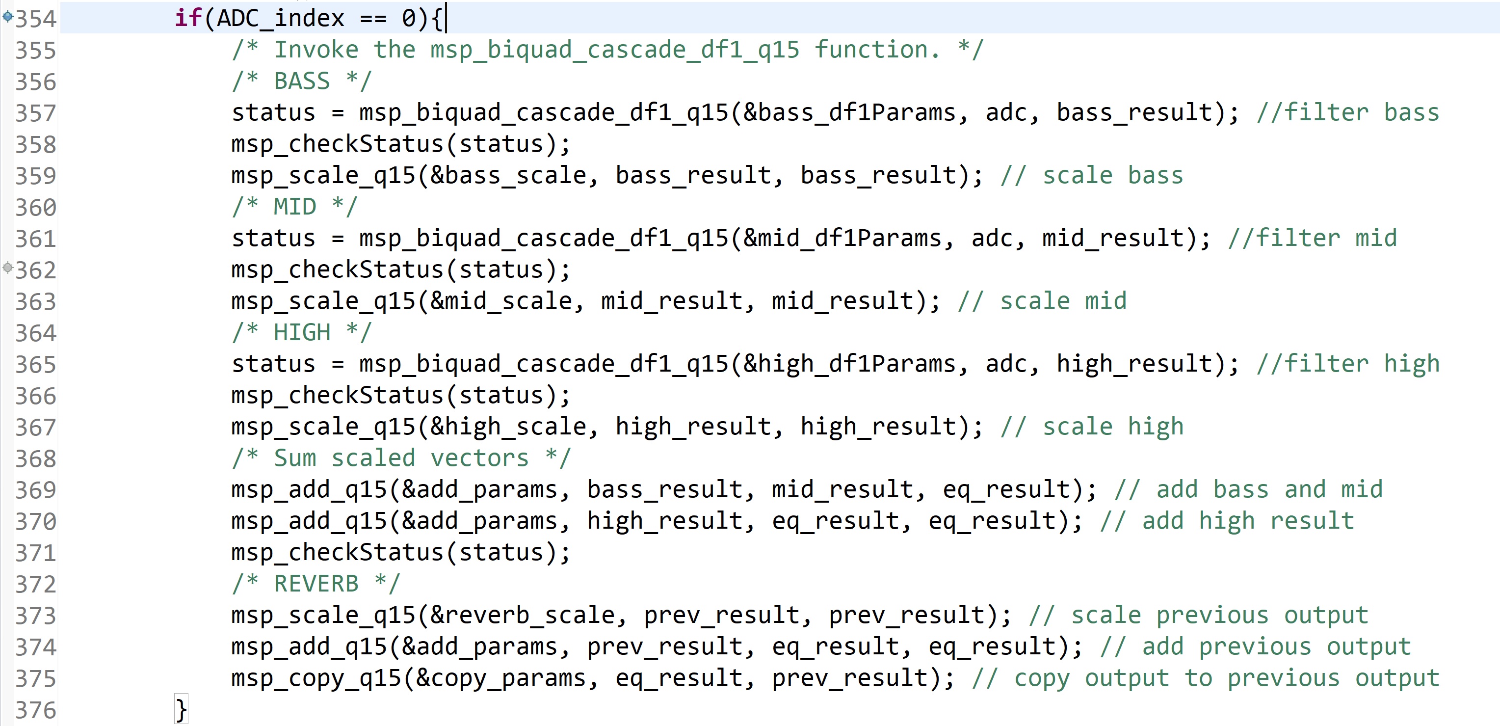
img/ctabachk_week15.jpg
