calvinwalterheintzelman/Senior-Design-Project-Website/img/image.jpg

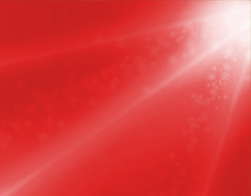
img/image.jpg
