calvinwalterheintzelman/Senior-Design-Project-Website/img/m1.png

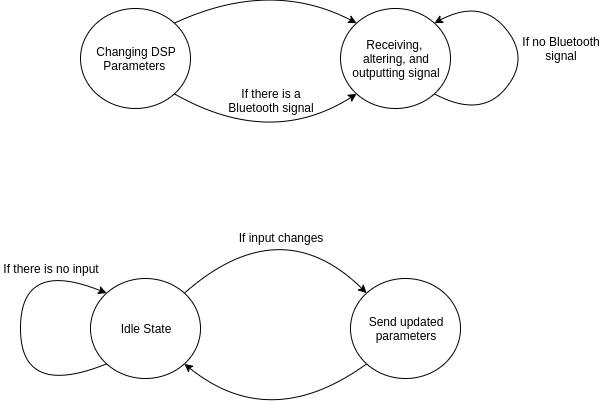
img/m1.png
