calvinwalterheintzelman/Senior-Design-Project-Website/img/ret0.png

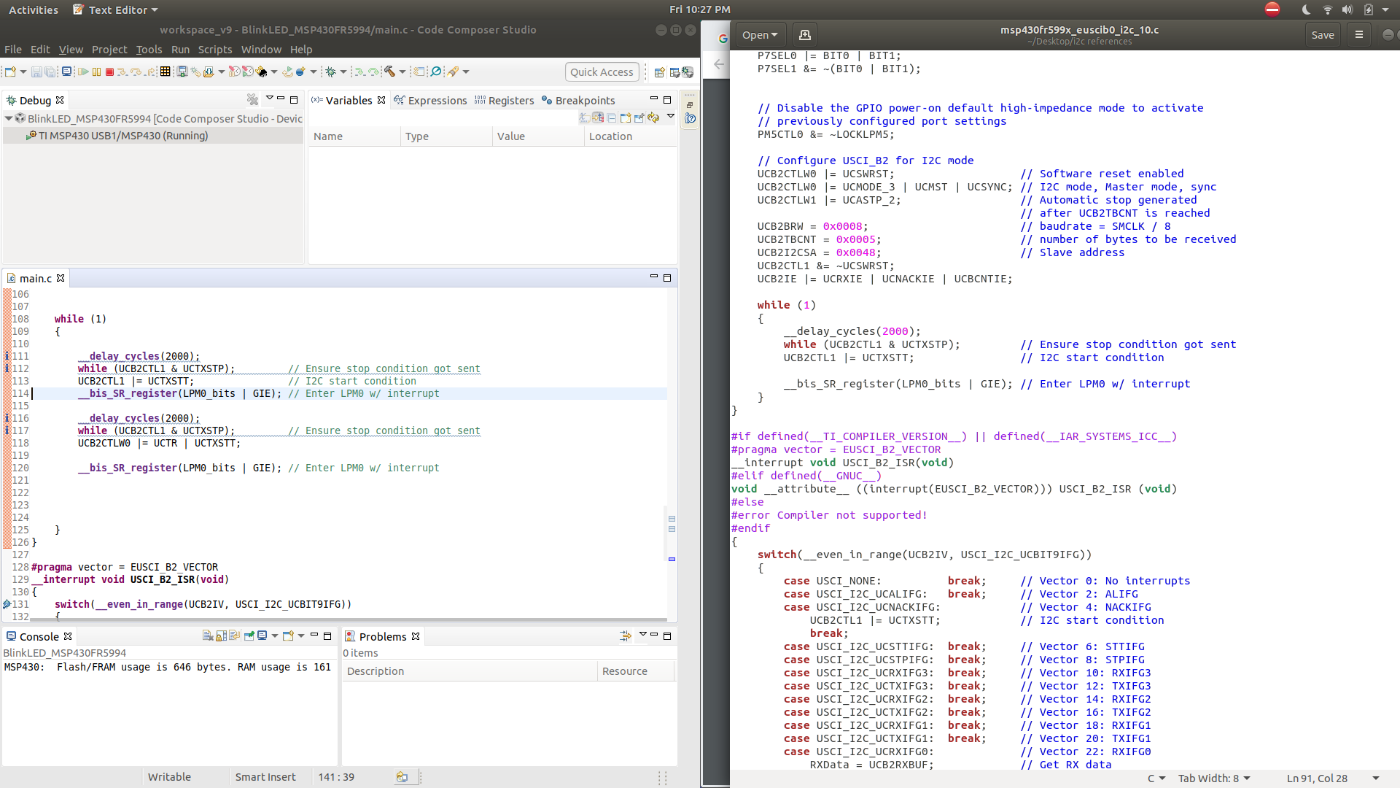
img/ret0.png
