calvinwalterheintzelman/Senior-Design-Project-Website/img/soot.png

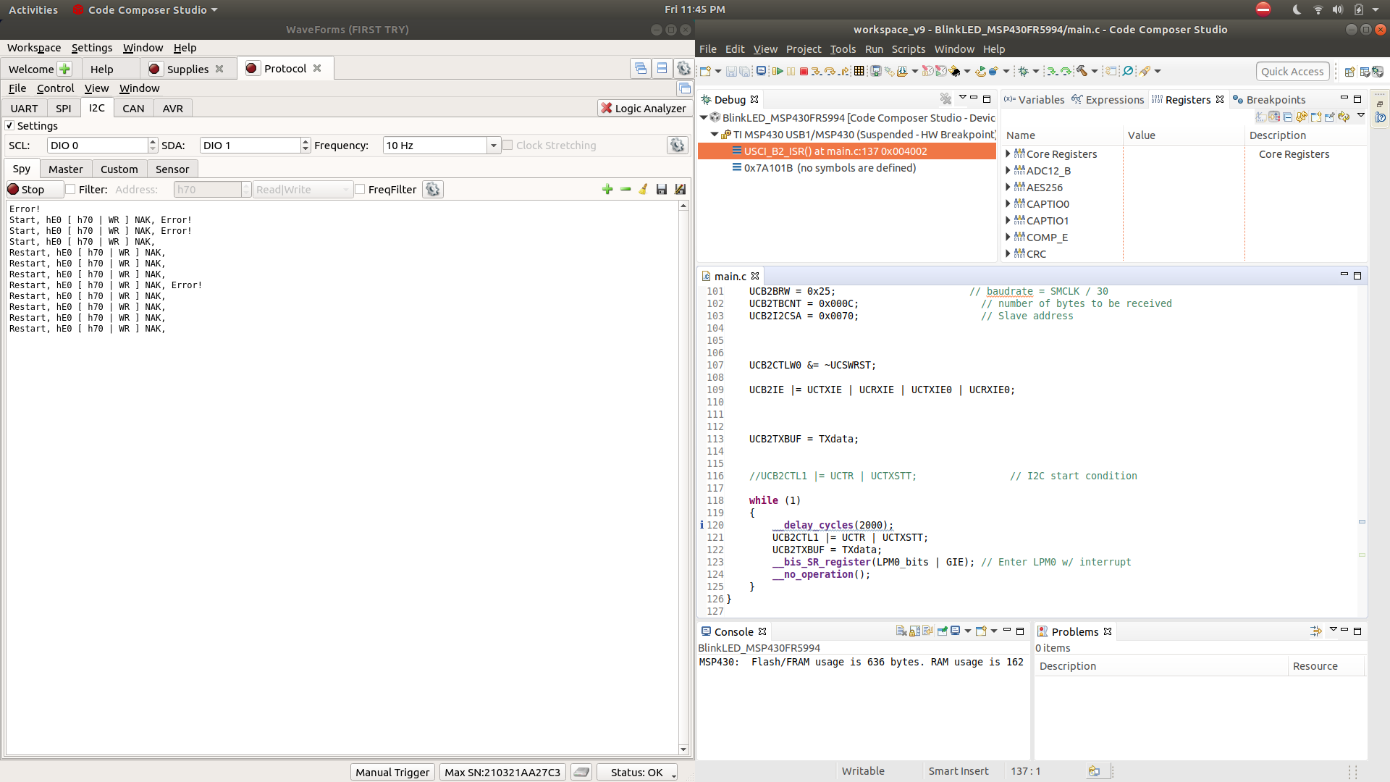
img/soot.png
