calvinwalterheintzelman/Senior-Design-Project-Website/img/stm32wb.jpg

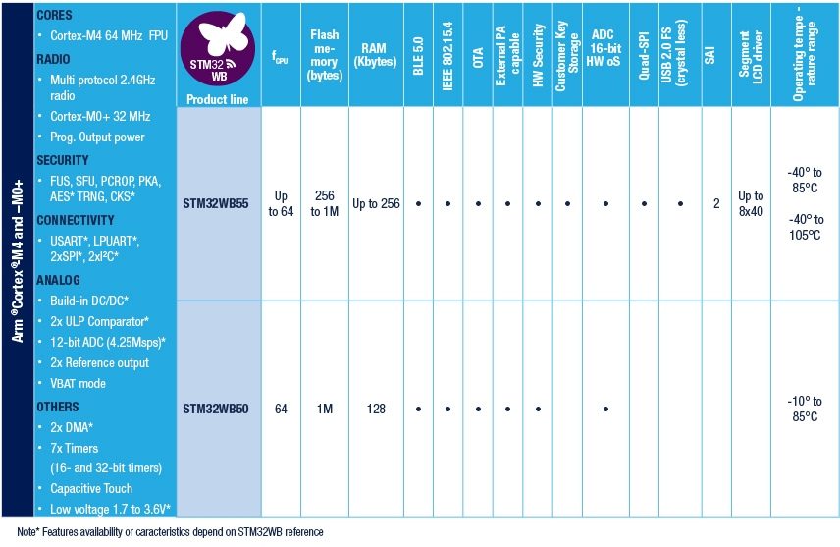
img/stm32wb.jpg
