calvinwalterheintzelman/Senior-Design-Project-Website/img/teamwork.jpg

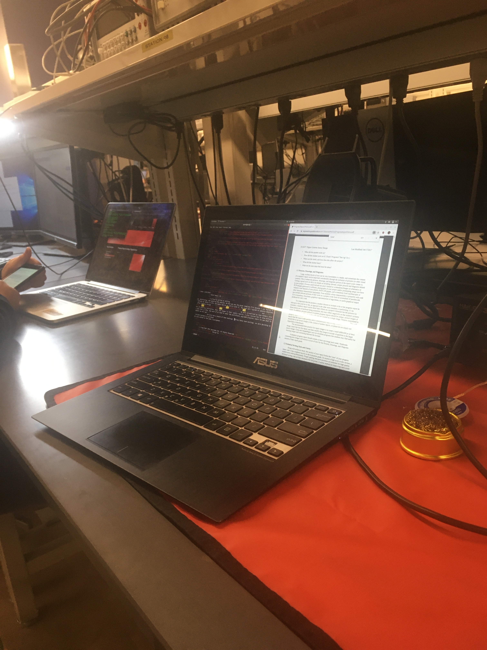
img/teamwork.jpg
