calvinwalterheintzelman/Senior-Design-Project-Website/img/thing1.png

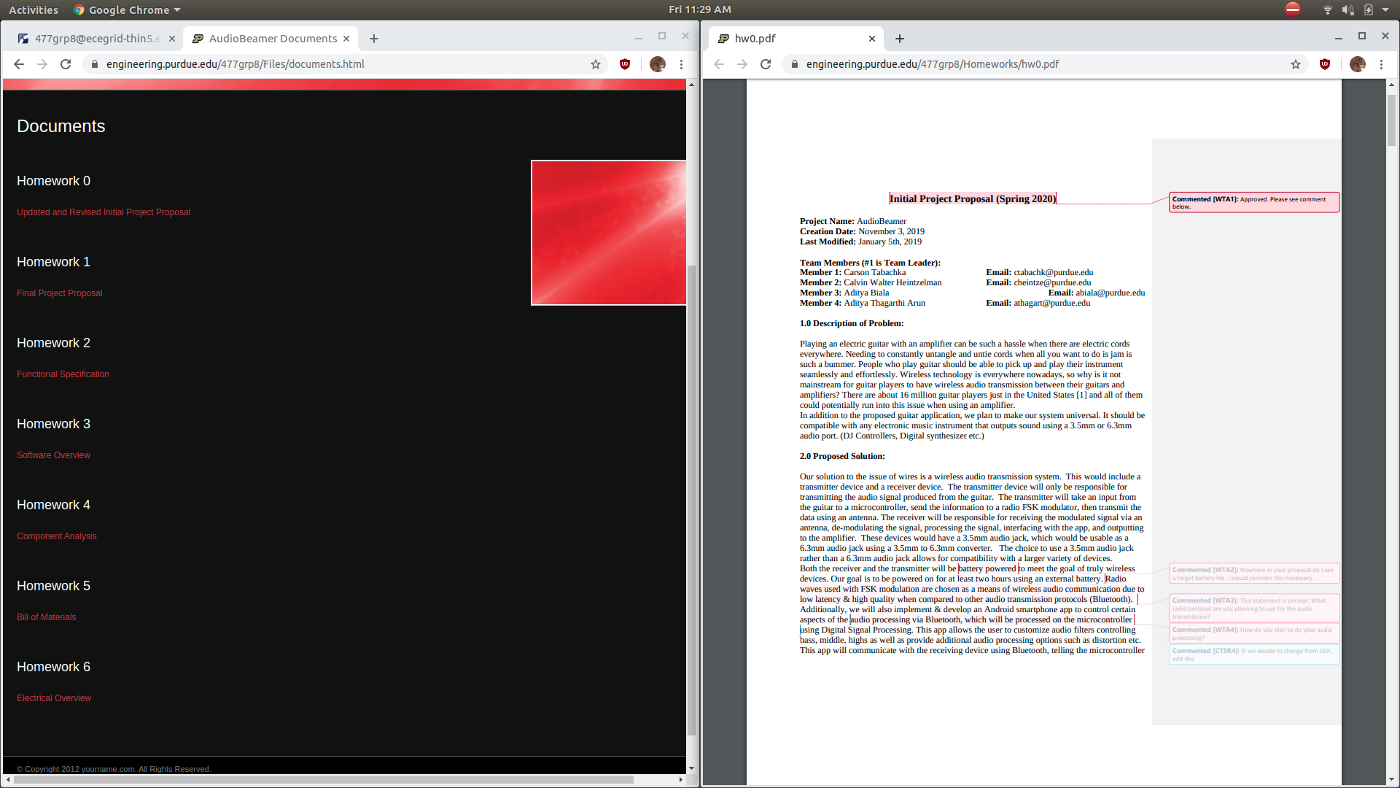
img/thing1.png
