calvinwalterheintzelman/Senior-Design-Project-Website/img/thing2.png

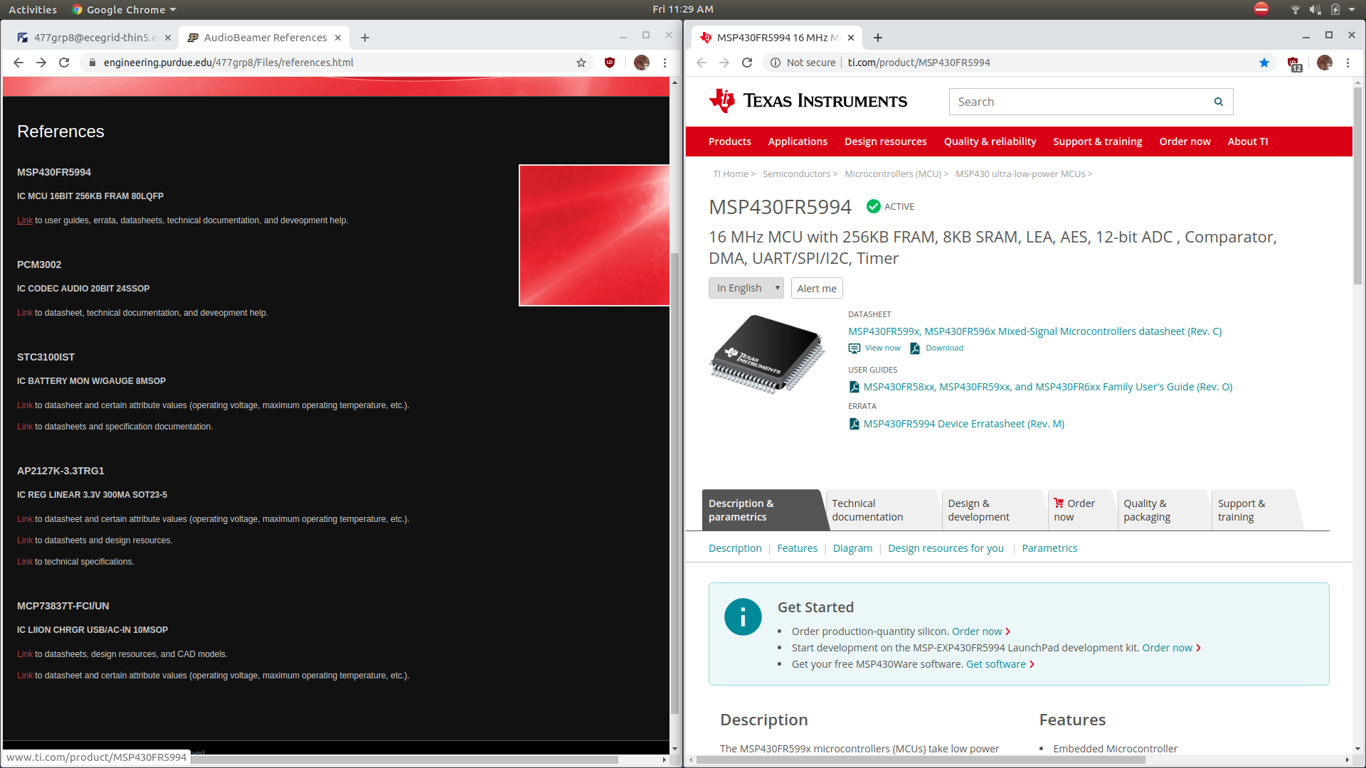
img/thing2.png
