calvinwalterheintzelman/Senior-Design-Project-Website/img/week9.png

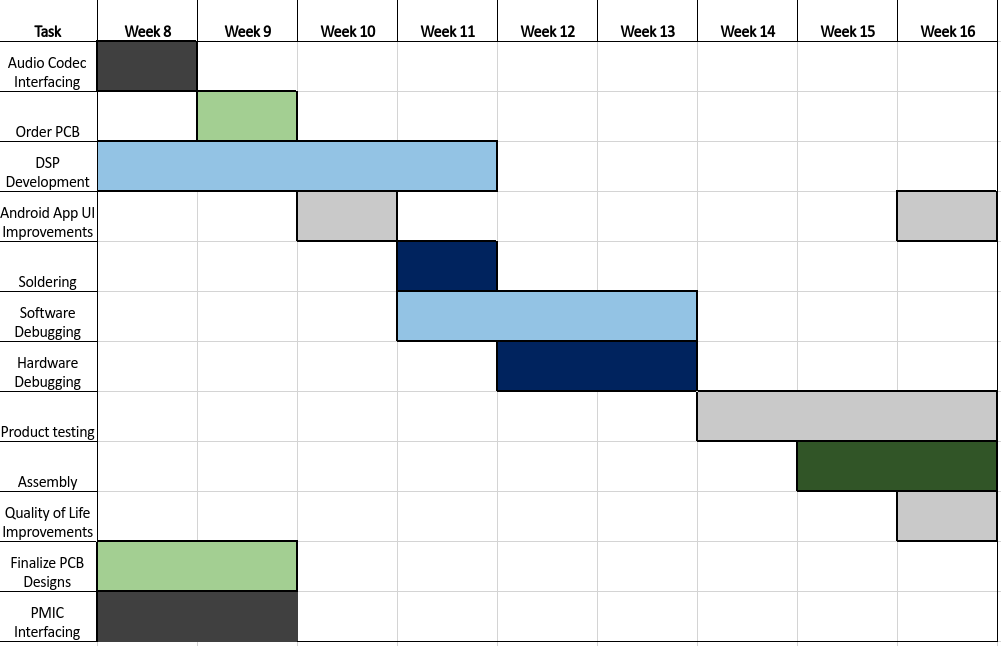
img/week9.png
