calvinwalterheintzelman/Senior-Design-Project-Website/img/work1.png

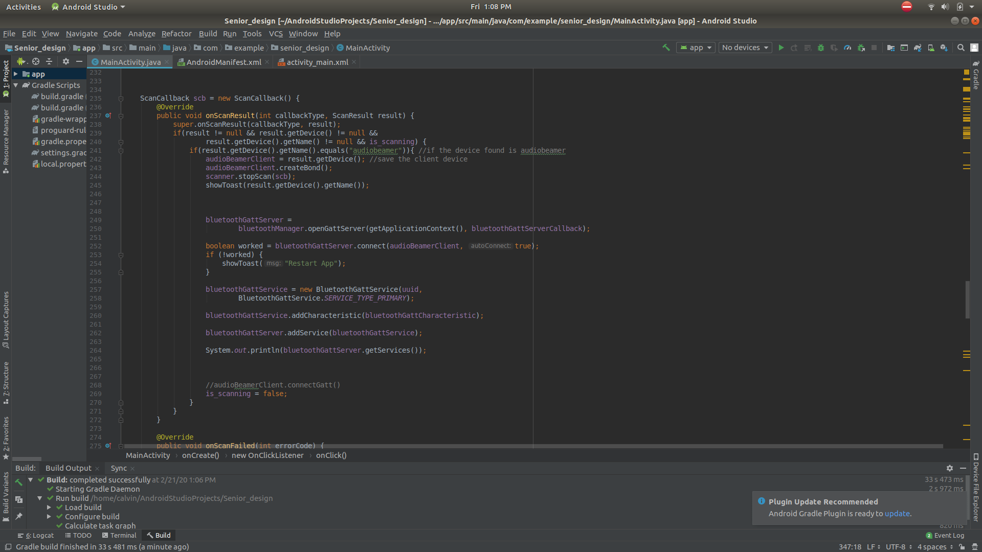
img/work1.png
