calvinwalterheintzelman/Senior-Design-Project-Website/Homeworks/hw5.xlsx

ECE477 Bill of Materials v1.0
Year: 2020 |  | Semester: Spring |  |  | Project Name: AudioBeamer
Author: Carson Tabachka | Email: ctabachk@purdue.edu
Author: Aditya Thagarthi Arun | Email: athagart@purdue.edu
Author: Aditya Biala | Email: abiala@purdue.edu
Author: Calvin Walter Heintzelman | Email: cheintze@purdue.edu
Created: 2/5/20
Last Modified: 2/5/20
Project_Component |  |  |  |  |  |  |  | Qty:
Description | ID | Qty | Value | Package | Manufacturer | Mfg. Part # | Supplier | Supplier Part #
IC MCU 16BIT 256KB FRAM 80LQFP | MSP430FR5994 | 2 |  | Surface Mount | Texas Instruments (VA) | MSP430FR5994IPNR | Digi-Key | 296-45561-1-ND
IC CODEC AUDIO 20BIT 24SSOP | PCM3002 | 2 |  | Surface Mount | Texas Instruments | PCM3002E | Digi-Key | 296-41602-5-ND
IC BATTERY MON W/GAUGE 8MSOP | STC3100IST | 2 |  | Surface Mount | STMicroelectronics (VA) | STC3100IST | Digi-Key | 497-10526-1-ND
IC REG LINEAR 3.3V 300MA SOT23-5 | AP2127K-3.3TRG1 | 2 |  | Surface Mount | Diodes Incorporated (VA) | AP2127K-3.3TRG1 | Digi-Key | AP2127K-3.3TRG1DICT-ND
IC LIION CHRGR USB/AC-IN 10MSOP | MCP73837T-FCI/UN | 2 |  | Surface Mount | Microchip Technology (VA) | MCP73837T-FCI/UN | Digi-Key | MCP73837T-FCI/UNCT-ND
